ThatOneGuyDavid/retro-tv-frame/SHARE-POST.md

# A retro TV frame for a modern display — work in progress

I wanted the warmth and chunky controls of an old television around a modern flat screen, so I designed a printed-and-wooden frame with an olive-green sculpted surround, brass-finished knobs, and a perforated speaker grille.

I’m sharing this before final assembly so others can explore or adapt it. The current bezel is v8, with a flat inner printing land; its test print was successful on 2026-11-10. Display fit and final assembly checks are still underway. The illustrations are CAD views, not completed-build photographs.

The design combines a few useful fabrication ideas: a two-piece bezel with hidden joining keys, glue feet that set the glass clearance, tapered tabs that locate against the factory frame, separately paintable knob parts, and a thin faceplate captured in a grooved mitered wood frame.

The repository includes the current printable parts, editable source, a browser assembly viewer, woodworking dimensions and cut list, and a faceplate-only template for ordinary Letter paper. It also explains the fitting features and how to adapt the design to a different display, including measurement worksheets and CAD-assistant prompt suggestions.

It is specified by measurements rather than a named monitor. The files describe the decorative front and frame; speaker mounting, control electronics and the final structural support can be chosen for your build.

Everything is shared under MIT. I'd love to see other finishes and adaptations.
