ThatOneGuyDavid/retro-tv-frame/docs/dimensions.md

# Example dimensions and coordinate system

These dimensions describe the current **bezel v8** and matching assembly. The v8 test print was successful; installation fit remains to be checked.

All dimensions are millimeters unless labeled otherwise. These measurements describe a **generic square-edged reference envelope**, not a named display model. The glass and housing are modeled as one solid unit; no internal display construction is inferred.

## Display

| Measurement | Value |
| --- | ---: |
| Viewing width × height | 596.9 × 336.55 (23.5 × 13.25 inches) |
| Factory border top / bottom | 34 / 48 |
| Factory border left / right | 33 / 33 |
| Factory front above glass | 7 |
| Complete housing width × height × depth | 662.9 × 418.55 × 44 |

Origin is the **center of the viewing surface**, with glass front **Z=0**, X right, Y up, Z toward the viewer. Factory frame front is Z=7 and housing back Z=-37. Because the lower border is taller, the housing's outer center is Y=-7. Housing bounds are X=±331.45, Y=-216.275..202.275, Z=-37..7.

## Front parts

| Feature | Size / position |
| --- | --- |
| Green opening | 587 × 326 bounding size, exponent-4 superellipse |
| Green sculpted outside | 641 × 370, exponent-8 superellipse |
| Green complete flange | 681 × 384 |
| Printed half | 340.5 × 384 × 29, independently translated to print Z0 |
| Green inner underside / visible top | Z1 / Z3.4 |
| Flat inner printing land | 2.2 mm top/bottom; 2.7 mm sides; installed Z1 / print Z0 |
| Peak / flange front | Z30 |
| Flange rear | Z27 |
| Nominal shell thickness in Z | 2.4 |
| Glue-foot contact bottoms | Z7.2 |
| Key seating / pocket floor | Z10.1..11.1 / Z11.2 |
| Wood rear / front | Z30.2 / Z33.375 |
| Knob plate rear | Z33.575 |
| Fixed dial rear | Z36.775 |
| Knob forward extent | Z64.575 |
| Control centerline | X392.5 |
| Knob centers | Y130, Y40 |
| Knob mounting plate | 108 × 186 × 3, center X392.5/Y90 |
| Dial diameter / grip diameter | 76 / nominal 46 |
| Grille print | 100 × 192 × 3, center X392.5/Y-102, front Z30 |
| Visible grille opening | 100 × 160, R8 |
| Green-to-grille envelope gap | 2 |

The rounded green opening overlaps the straight glass rectangle by approximately 5 mm per axis at the straight middle edges and more at the corners. It is an intentional mask; this is not a design for preserving every pixel of a rectangular image.

## Wood

| Feature | Value |
| --- | --- |
| Panel width × height | 803.2 × 434.75 |
| Panel thickness | 3.175 |
| Panel X bounds | -348.6..454.6 |
| Panel Y bounds | -224.375..210.375 |
| Rail inside X bounds | -342.5..448.5 |
| Rail inside Y bounds | -218.275..204.275 |
| Frame outside width × height | 829.1 × 460.65 |
| Rail cross-section | 19.05 front width × 76.2 rearward depth |
| Frame front / rear | Z36.375 / Z-39.825 |
| Groove depth / width | 6.35 / 3.575 |
| Groove front/back from rail front | 2.8 / 6.375 |
| Panel front setback from rail front | 3 |
| Screen wood opening | 640 × 369 curved contour |
| Speaker wood opening | 100 × 160, R8 |

Faceplate drawing is front view, TOP up. Match the actual curved screen contour; dimensions alone do not reproduce its corners. Shaft holes are not in the clean woodworking template because the hardware-specific openings have not been selected.
