ThatOneGuyDavid/retro-tv-frame/design/faceplate/faceplate-letter-tiled.pdf

0 | 50 | 100

100 mm check

1 inch square

WOOD FACEPLATE — US LETTER TEMPLATE

Print every page at ACTUAL SIZE / 100%. Disable Fit, Shrink, and Scale to printable area. Use 8.5 × 11 inch portrait paper, one-sided.

First verify the 100 mm bar below with a ruler.
The 1 inch square must measure 25.4 mm on both axes. If either dimension is wrong, do not use the template.

Tiles: 5 columns × 2 rows; 10 mm overlap.
Arrange row 1 above row 2; columns left to right. Trim ONE side of each shared margin, overlap the drawings, and match grid crosses and cut lines.
Do not align by paper edges alone.

SOLID black lines: outer wood boundary and cutouts. Fine crosses and dotted lines are tile alignment guides. Only the faceplate boundary and cutouts are shown.

Panel: 803.2 × 434.75 mm; screen opening: 640 × 369 mm. Screen contour is curved, NOT a bounding rectangle. Grille opening: 100 × 160 mm, corner radius 8 mm.
View is FRONT / TOP UP. Attach template to wood front.

Dry-fit printed parts before cutting final material.

1/8 inch wood shown in assembly; thinner is possible. Check against the actual prints before cutting wood.

TOP / FRONT VIEW

R1 C1 | FRONT / TOP UP | Actual size 100% | 10 mm overlap

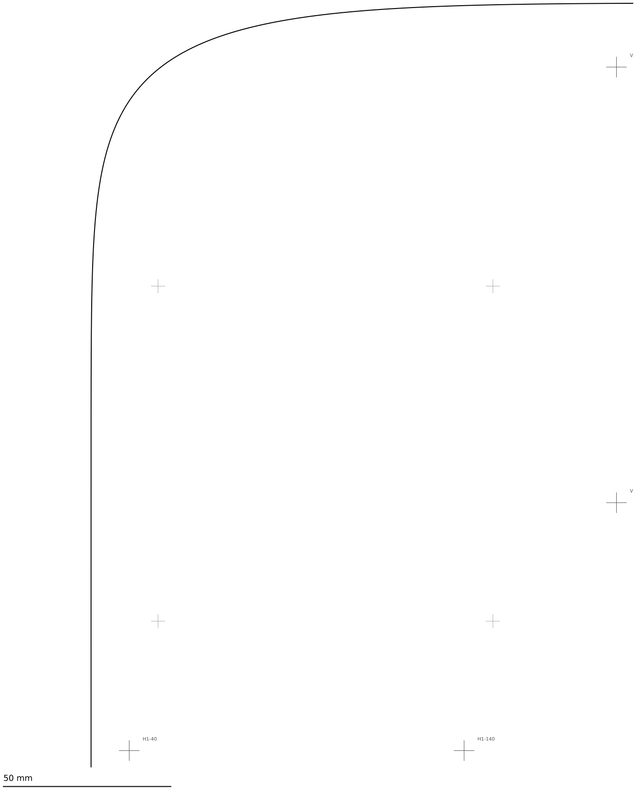
[picture p3: figure]

SCREEN CUTOUT

V1-1-45

V1-1-175

V2-1-45

V2-1-175

R1 C2 | FRONT / TOP UP | Actual size 100% | 10 mm overlap

SCREEN CUTOUT

V2-1-45

V2-1-175

V3-1-45

V3-1-175

R1 C3 | FRONT / TOP UP | Actual size 100% | 10 mm overlap

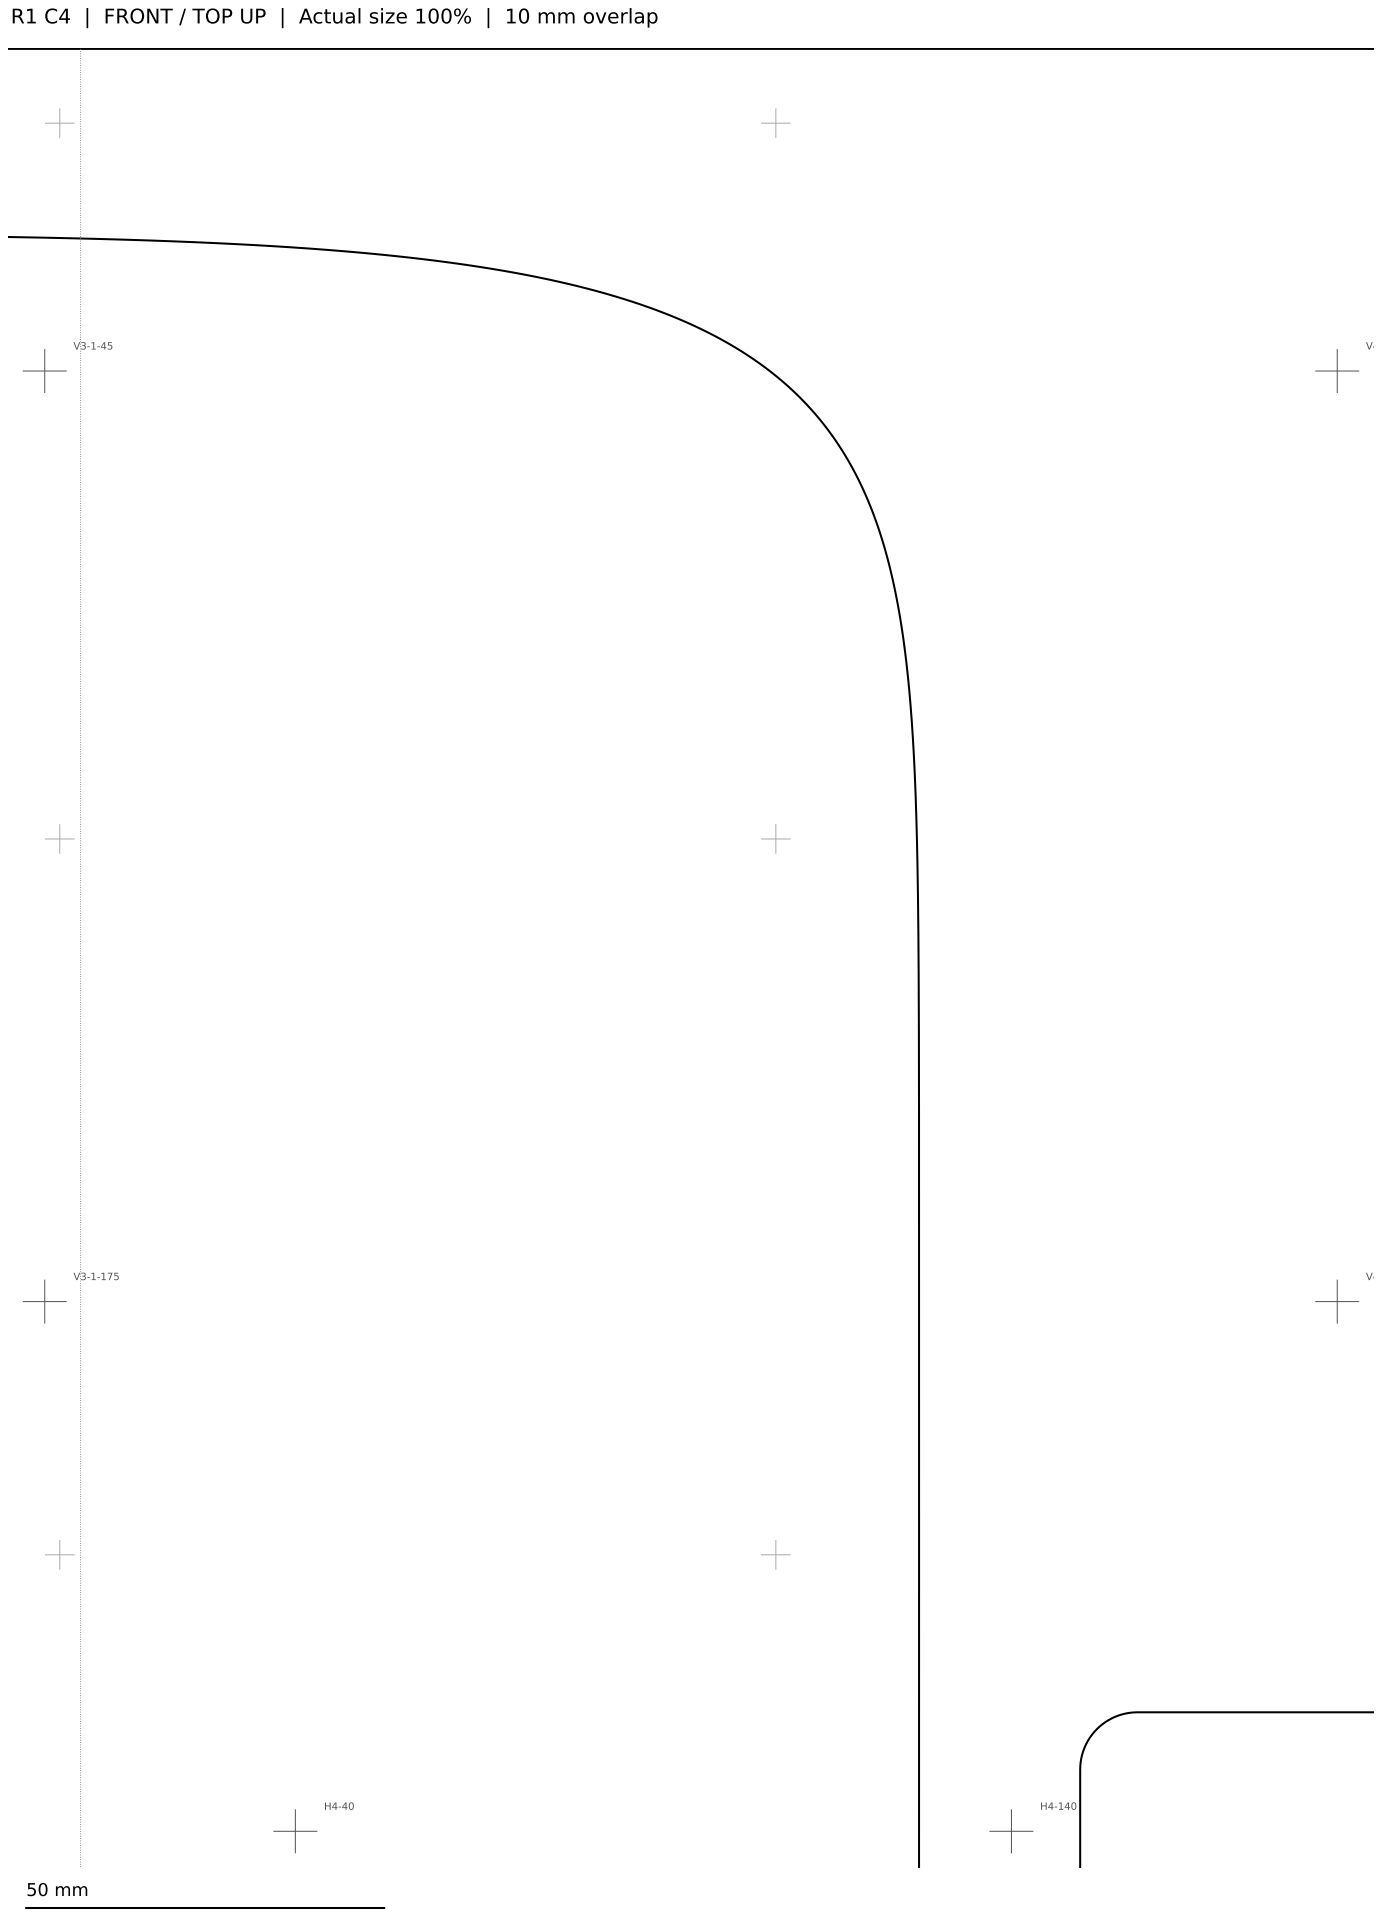
[picture p4: page 5]

R1 C4 | FRONT / TOP UP | Actual size 100% | 10 mm overlap

V4-1-45

V4-1-175

R1 C5 | FRONT / TOP UP | Actual size 100% | 10 mm overlap

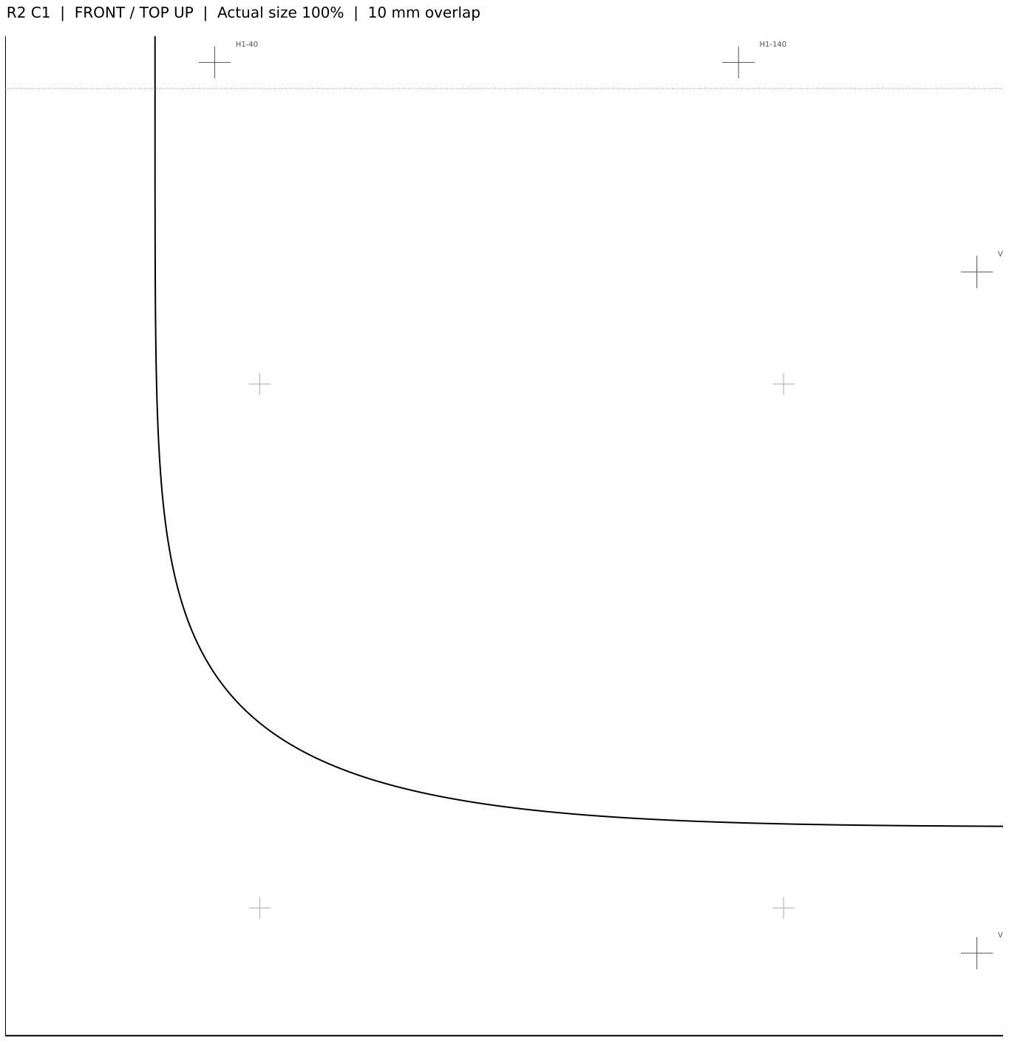
[picture p5: figure]

R2 C1 | FRONT / TOP UP | Actual size 100% | 10 mm overlap

V1-2-45

V1-2-175

V2-2-45

V2-2-175

R2 C2 | FRONT / TOP UP | Actual size 100% | 10 mm overlap

V2-2-45

V2-2-175

V3-2-45

V3-2-175

R2 C3 | FRONT / TOP UP | Actual size 100% | 10 mm overlap

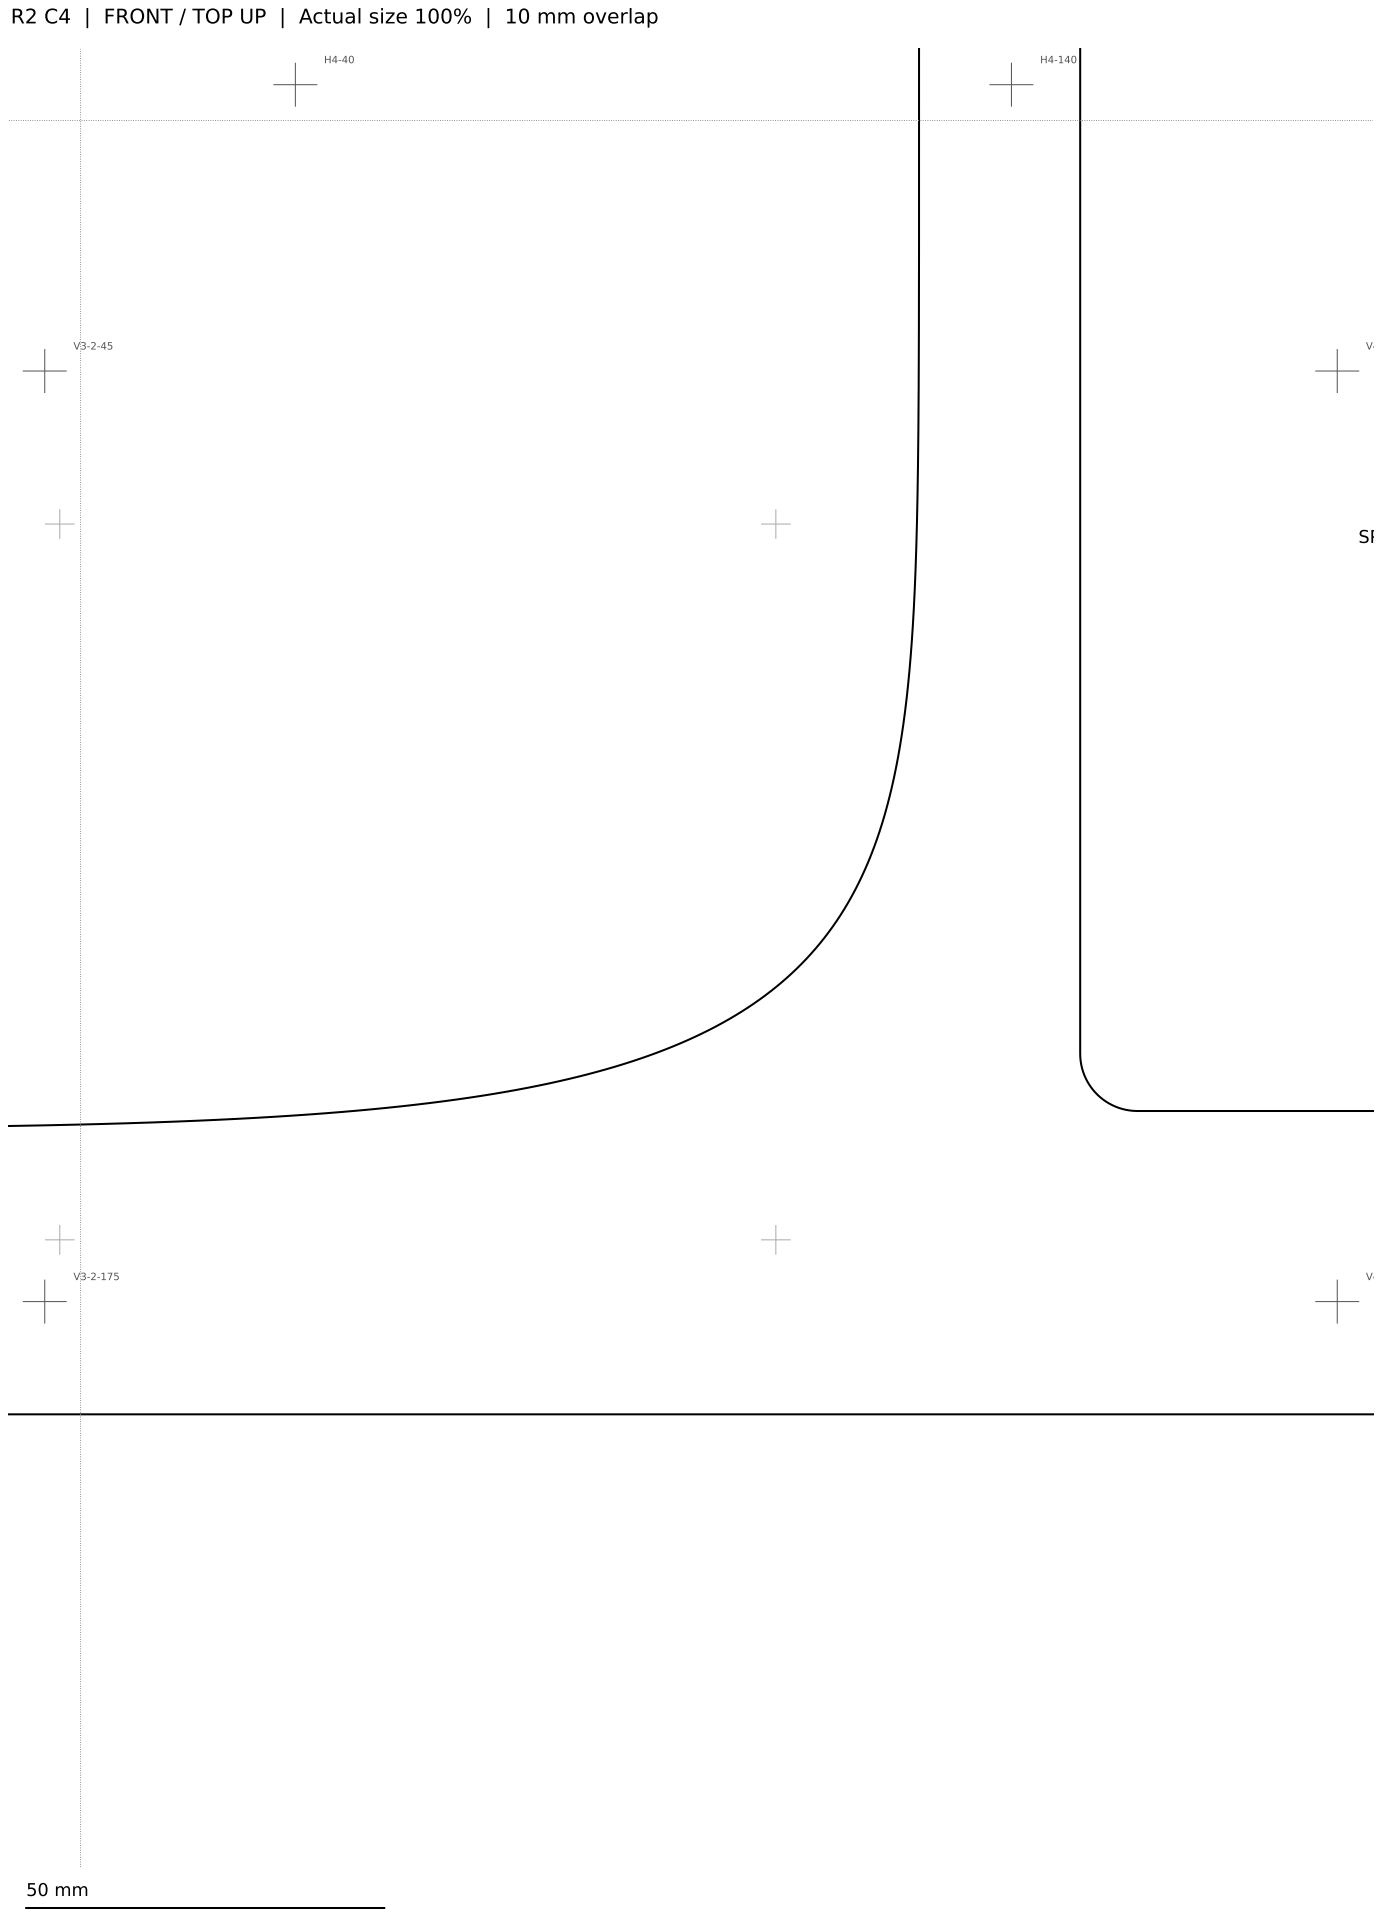
[picture p6: page 10]
SPEAKER CUTOUT

R2 C4 | FRONT / TOP UP | Actual size 100% | 10 mm overlap

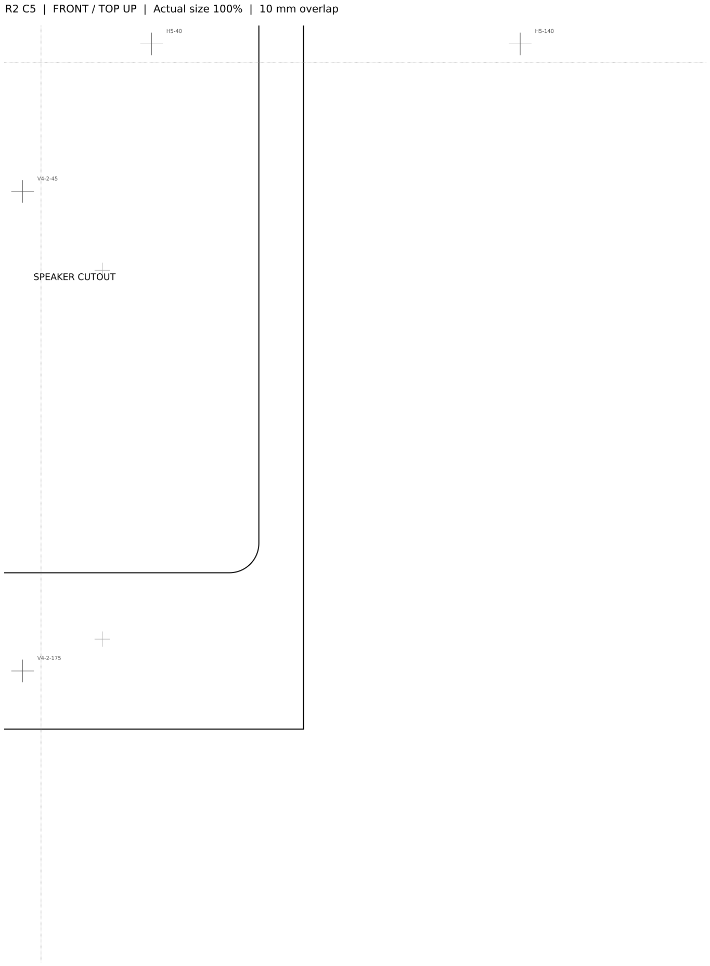
[picture p7: figure]
SPEAKER CUTOUT

R2 C5 | FRONT / TOP UP | Actual size 100% | 10 mm overlap
