ThatOneGuyDavid/retro-tv-frame/design/bezel/first-layer-brim.png

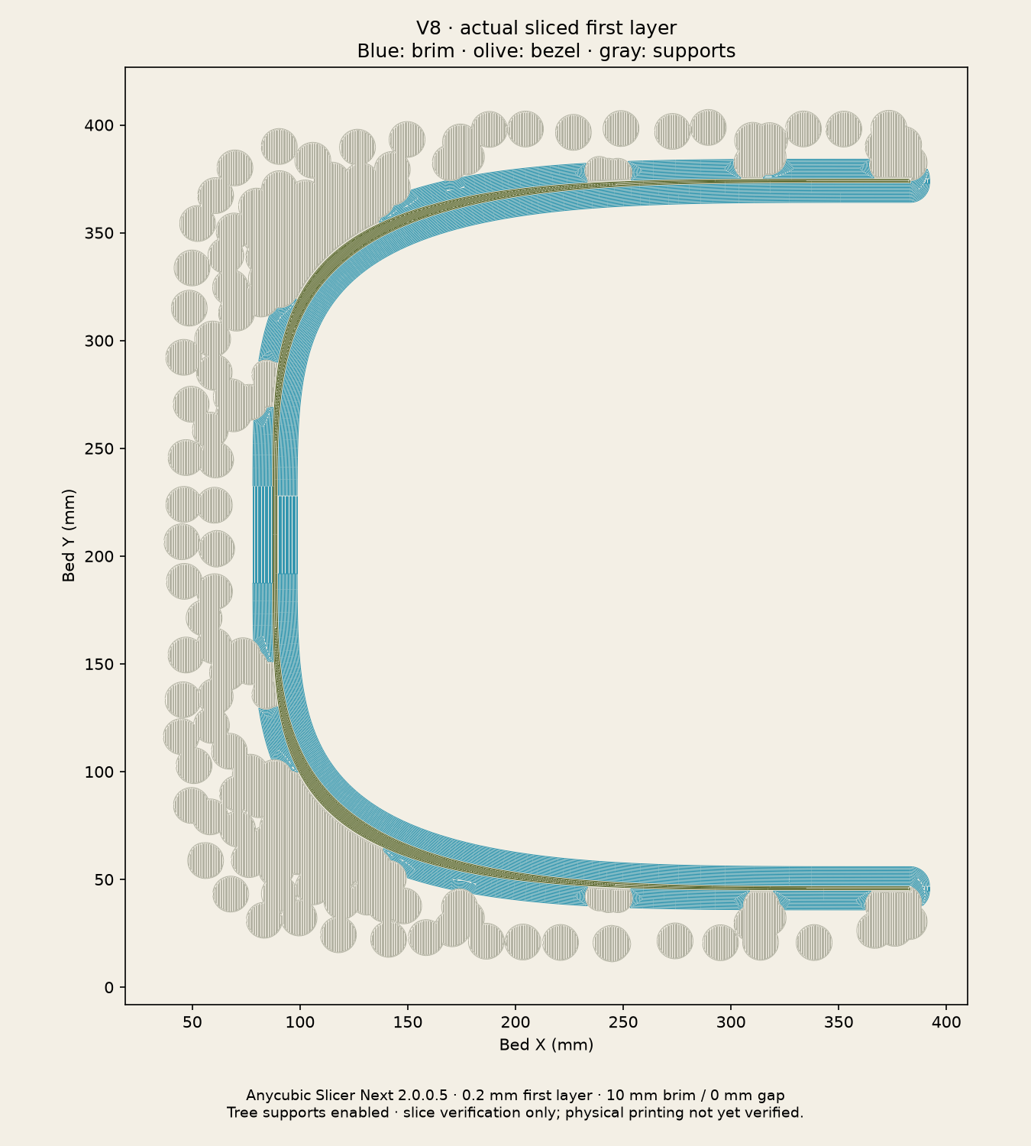
design/bezel/first-layer-brim.png
