ThatOneGuyDavid/retro-tv-frame/design/faceplate/faceplate-preview.png

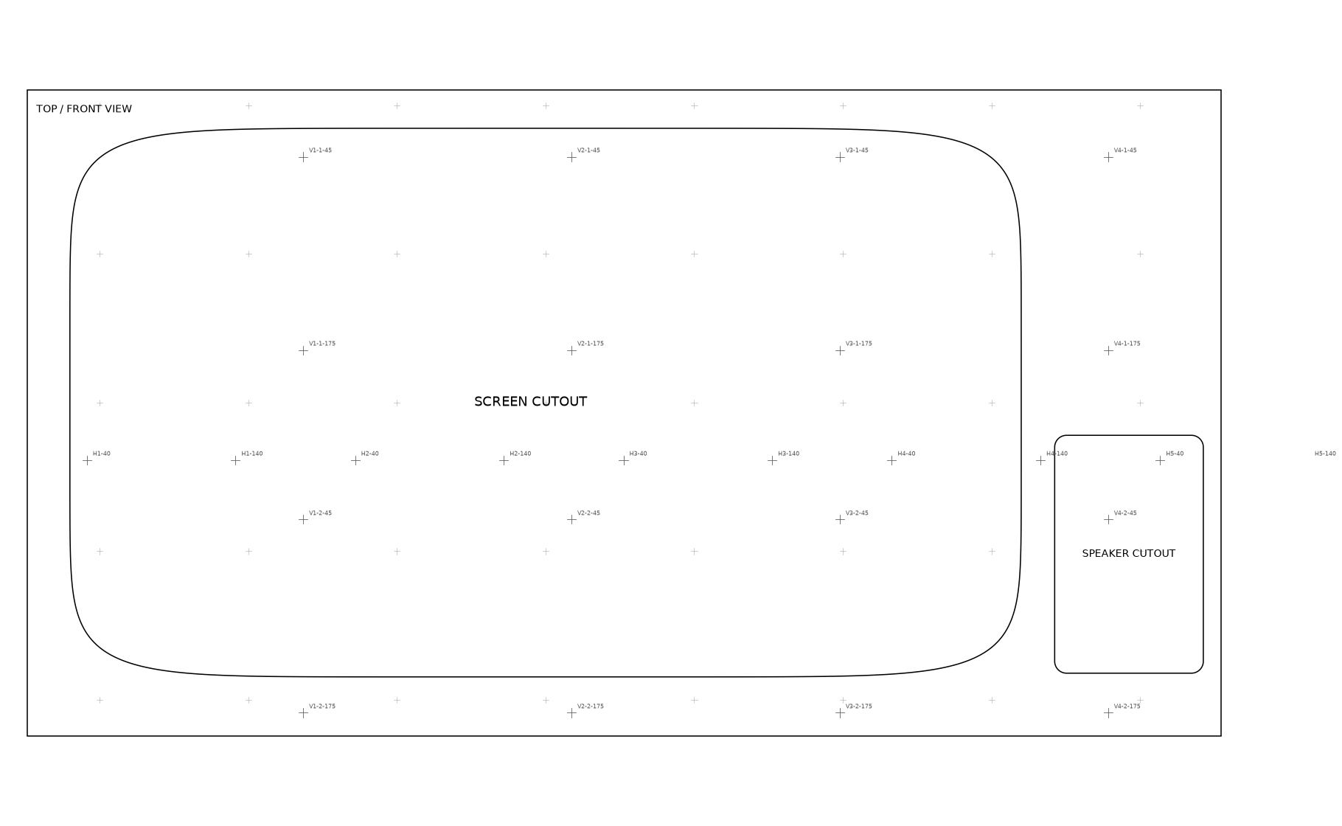
design/faceplate/faceplate-preview.png
