ThatOneGuyDavid/retro-tv-frame/design/grille/grille-preview.png

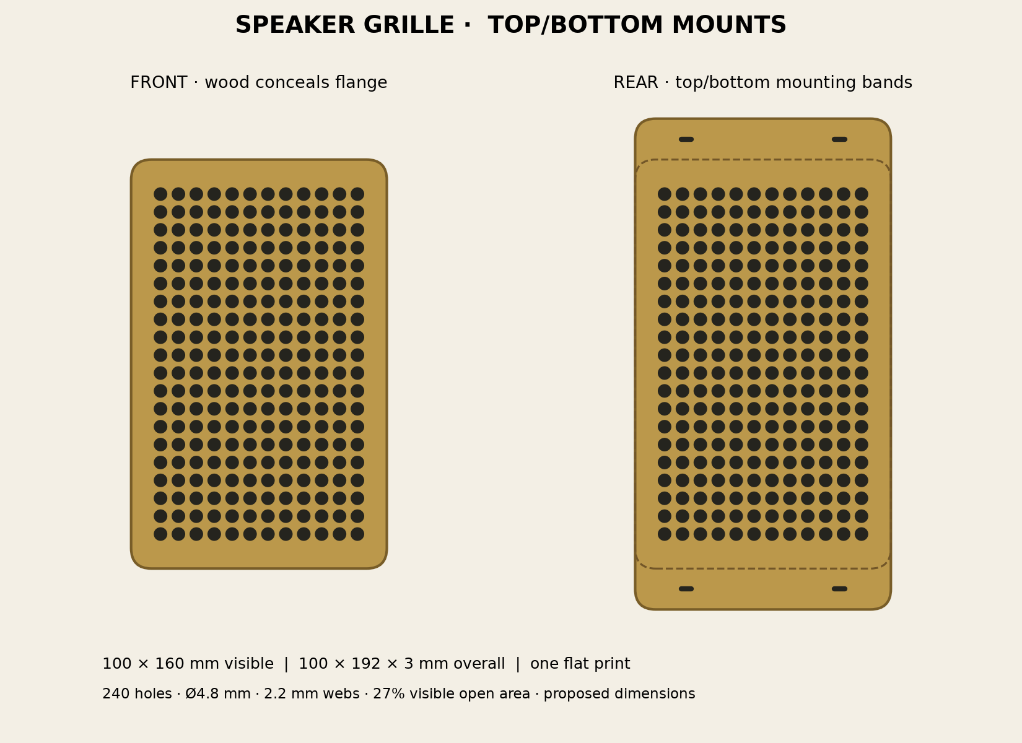
design/grille/grille-preview.png
