ThatOneGuyDavid/retro-tv-frame/design/knobs/knob-exploded.png

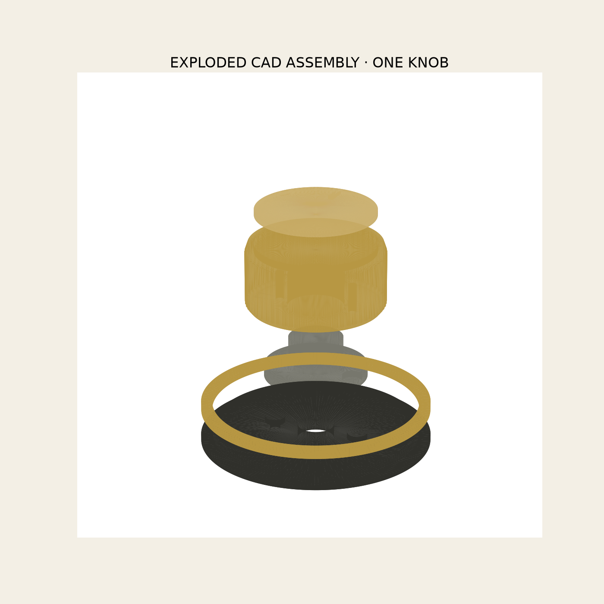
design/knobs/knob-exploded.png
