ThatOneGuyDavid/retro-tv-frame/design/knobs/knob-preview.png

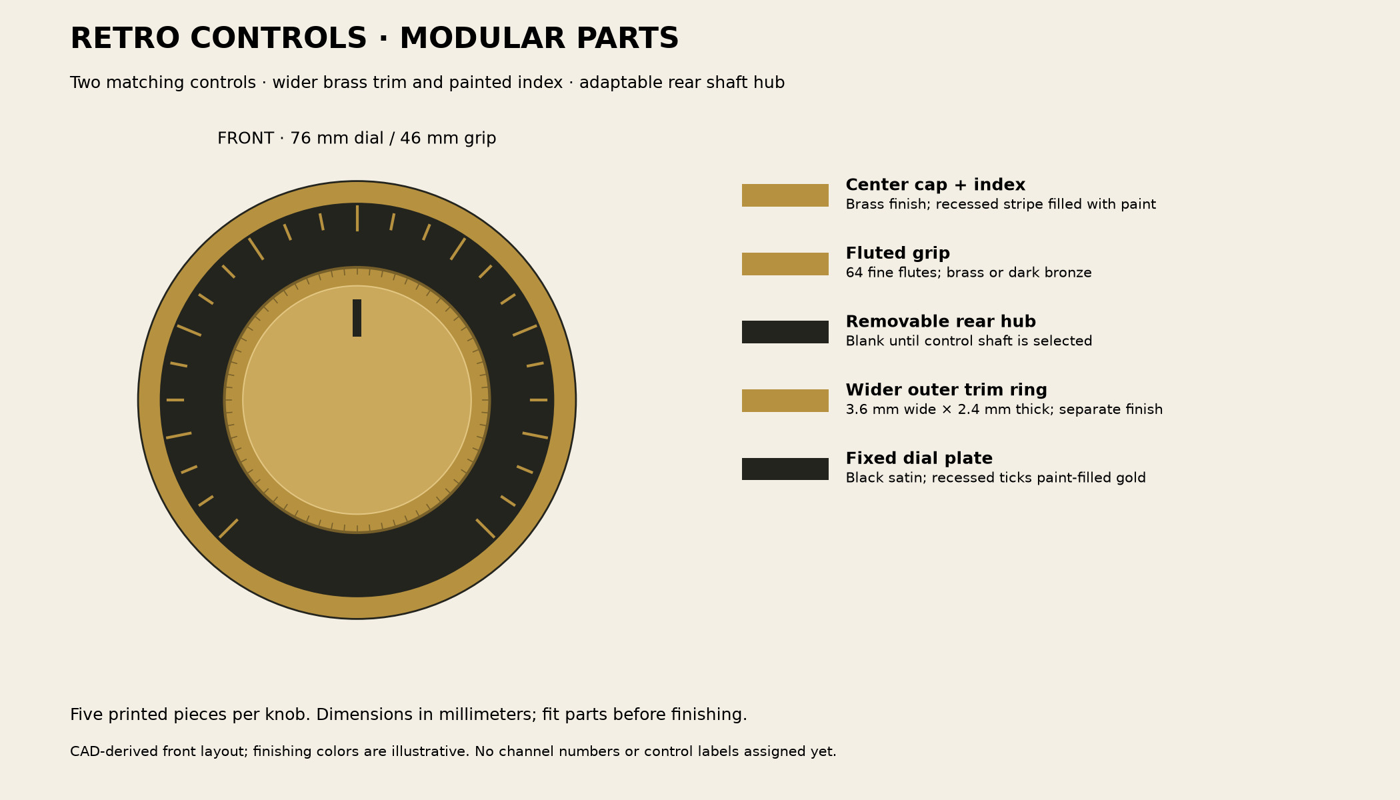
design/knobs/knob-preview.png
