ThatOneGuyDavid/retro-tv-frame/design/bezel/bezel-assembled.step

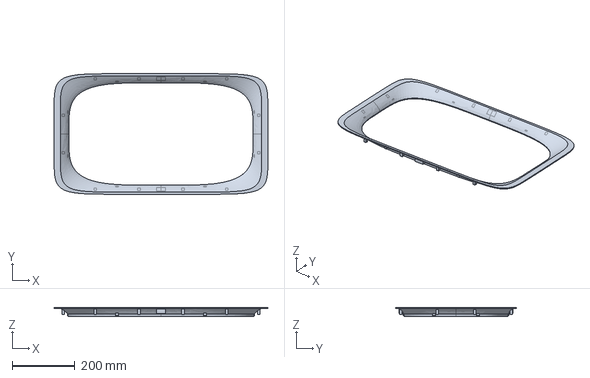
[picture p13: CAD file, 2026-11-12]
design/bezel/bezel-assembled.step
681.0 x 384.0 x 29.0 mm
