ThatOneGuyDavid/retro-tv-frame/design/assembly/wood-frame-bottom-reference.stl

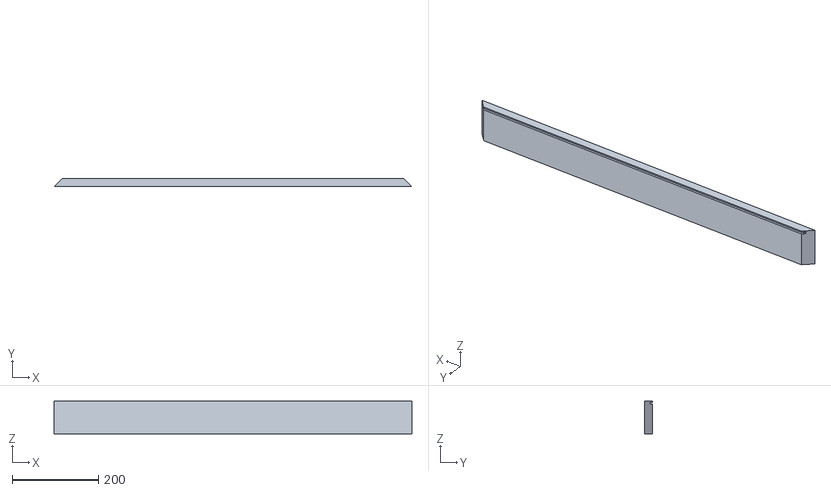
[picture p14: CAD file, 2026-11-09]
design/assembly/wood-frame-bottom-reference.stl
829.1 x 19.1 x 76.2
