ThatOneGuyDavid/retro-tv-frame/design/bezel/bezel-right.step

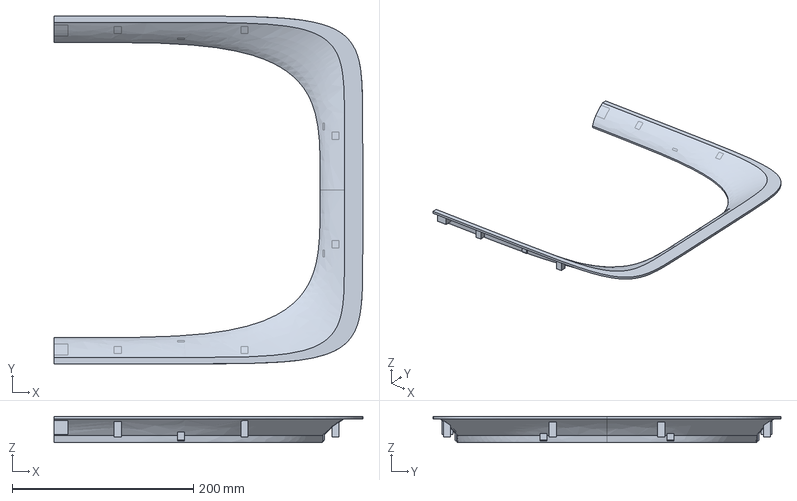
[picture p15: CAD file, 2026-11-12]
design/bezel/bezel-right.step
340.5 x 384.0 x 29.0 mm
