ThatOneGuyDavid/retro-tv-frame/design/display/display-reference.stl

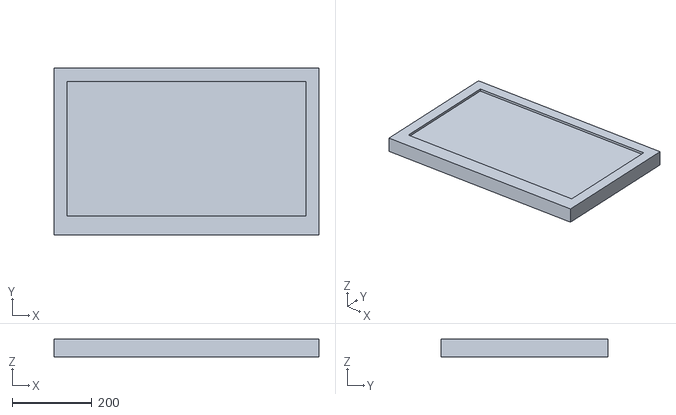
[picture p16: CAD file, 2026-11-09]
design/display/display-reference.stl
662.9 x 418.5 x 44.0
