ThatOneGuyDavid/retro-tv-frame/design/grille/speaker-grille.stl

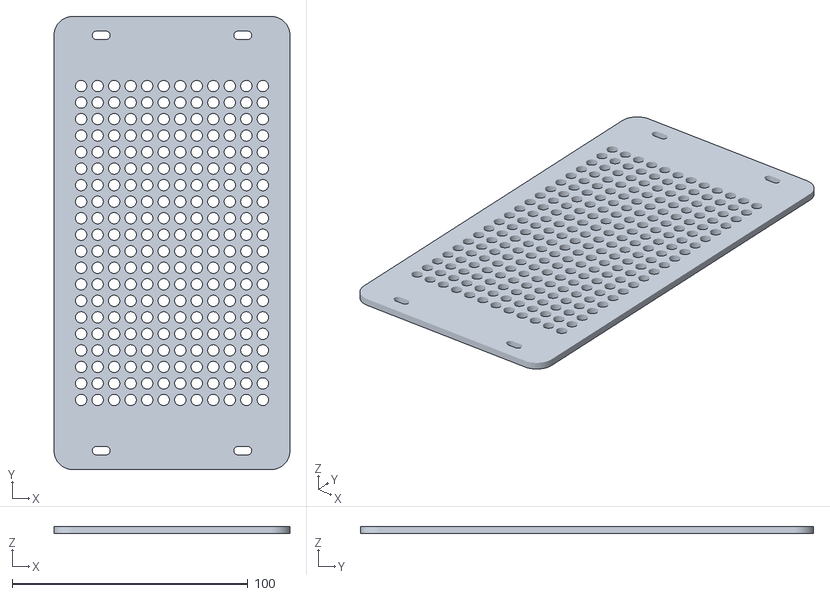
[picture p17: CAD file, 2026-11-09]
design/grille/speaker-grille.stl
100.0 x 192.0 x 3.00
