ThatOneGuyDavid/retro-tv-frame/design/knobs/fluted-grip.stl

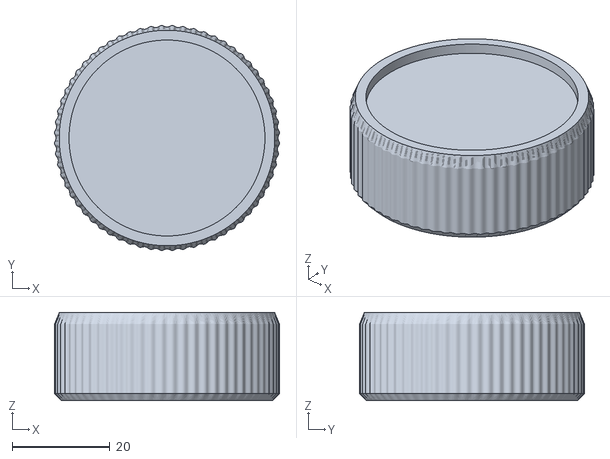
[picture p18: CAD file, 2026-11-09]
design/knobs/fluted-grip.stl
45.9 x 45.9 x 18.0
