ThatOneGuyDavid/retro-tv-frame/design/assembly/knob-mounting-plate.stl

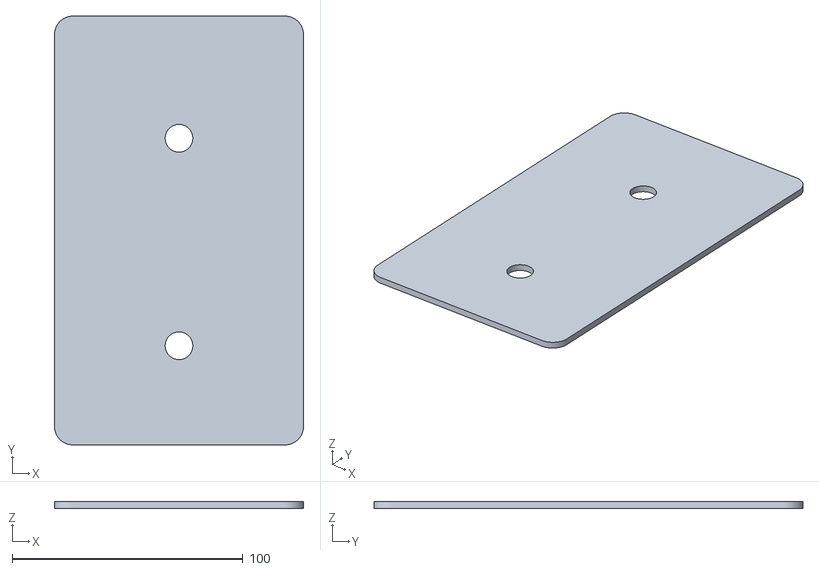
[picture p19: CAD file, 2026-11-09]
design/assembly/knob-mounting-plate.stl
108.0 x 186.0 x 3.00
