ThatOneGuyDavid/retro-tv-frame/design/bezel/joining-key.step

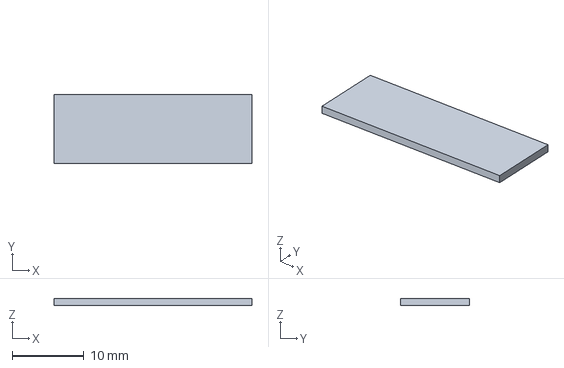
[picture p20: CAD file, 2026-11-12]
design/bezel/joining-key.step
27.6 x 9.60 x 1.00 mm
