ThatOneGuyDavid/retro-tv-frame/design/grille/perforation-test.stl

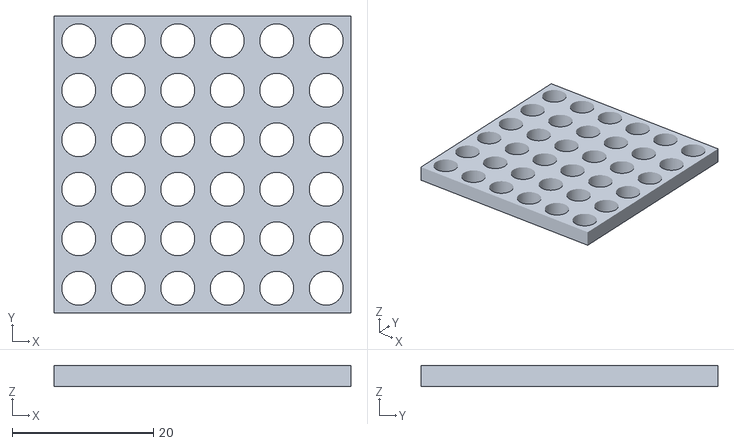
[picture p21: CAD file, 2026-11-09]
design/grille/perforation-test.stl
42.0 x 42.0 x 3.00
