ThatOneGuyDavid/retro-tv-frame/design/knobs/dial-plate.stl

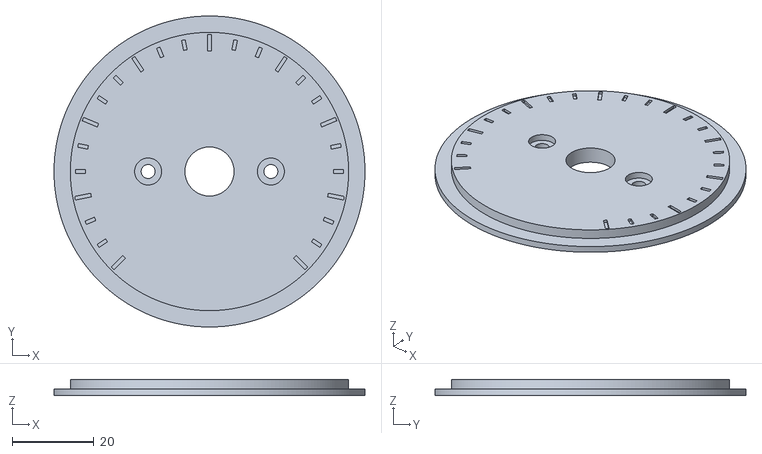
[picture p22: CAD file, 2026-11-09]
design/knobs/dial-plate.stl
76.0 x 76.0 x 4.00
