ThatOneGuyDavid/retro-tv-frame/design/assembly/wood-frame-left-reference.stl

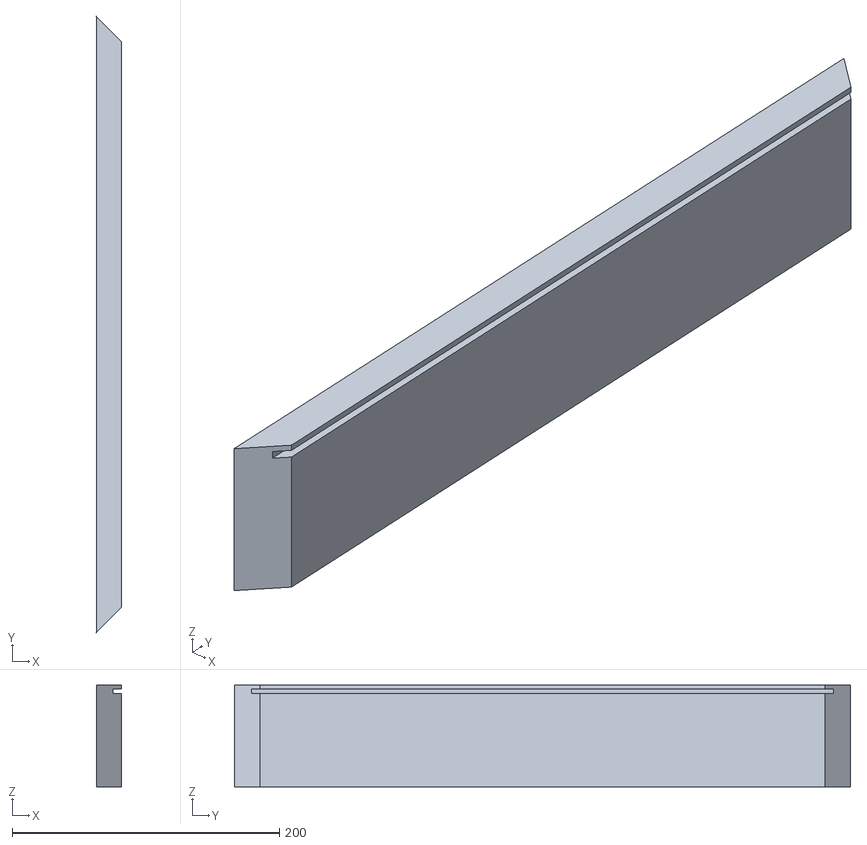
[picture p23: CAD file, 2026-11-09]
design/assembly/wood-frame-left-reference.stl
19.0 x 460.6 x 76.2
