ThatOneGuyDavid/retro-tv-frame/design/knobs/brass-trim.stl

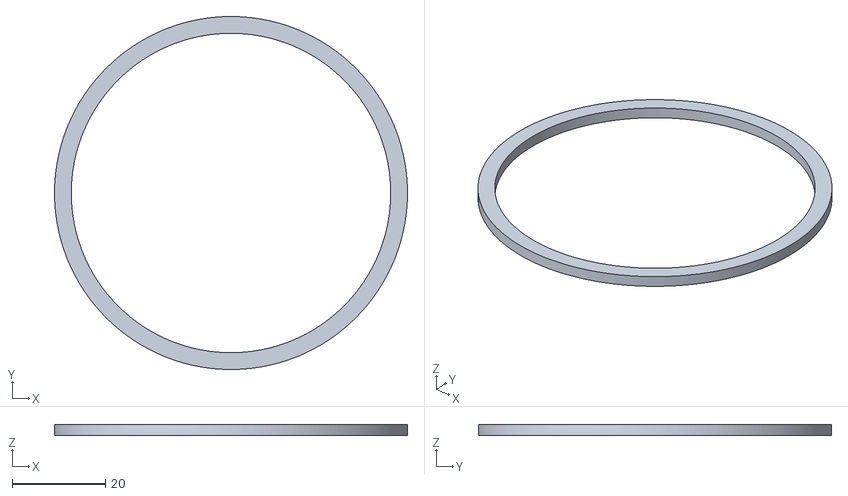
[picture p24: CAD file, 2026-11-09]
design/knobs/brass-trim.stl
75.6 x 75.6 x 2.40
