ThatOneGuyDavid/retro-tv-frame/design/knobs/blank-hub.stl

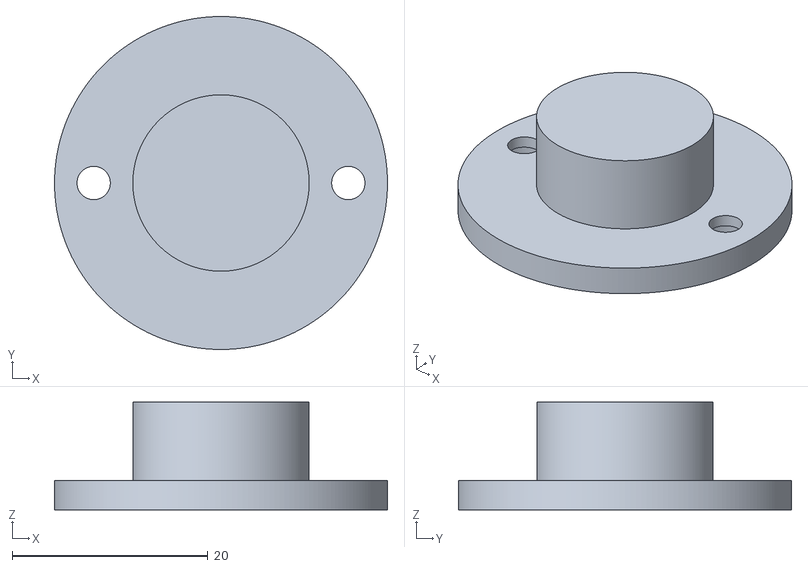
[picture p25: CAD file, 2026-11-09]
design/knobs/blank-hub.stl
34.0 x 34.0 x 11.0
