ThatOneGuyDavid/retro-tv-frame/design/assembly/wood-faceplate-reference.stl

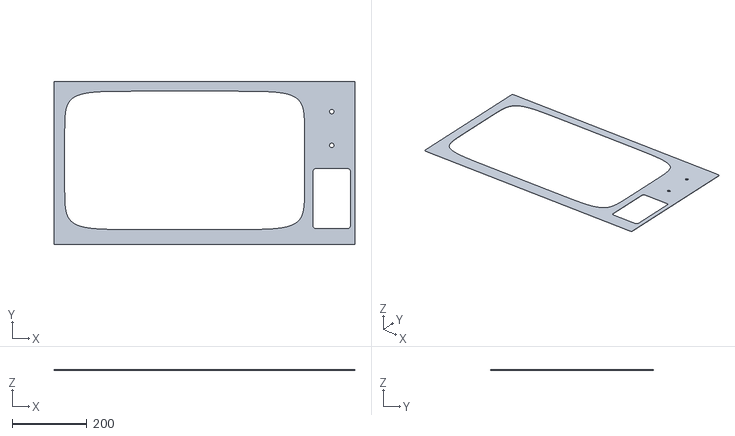
[picture p26: CAD file, 2026-11-09]
design/assembly/wood-faceplate-reference.stl
803.2 x 434.8 x 3.17
