ThatOneGuyDavid/retro-tv-frame/design/bezel/joint-test-left.stl

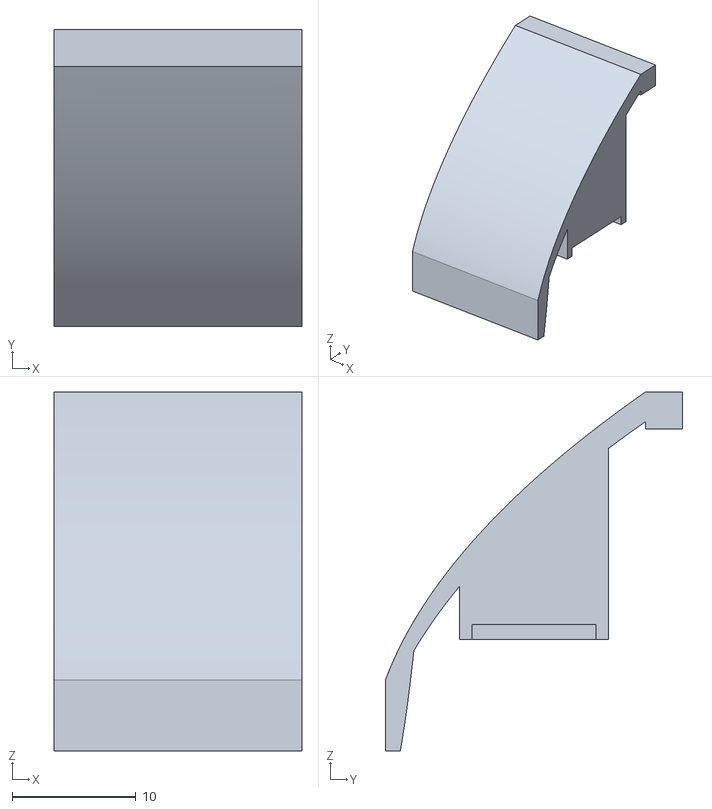
[picture p27: CAD file, 2026-11-09]
design/bezel/joint-test-left.stl
20.0 x 24.0 x 29.0
