ThatOneGuyDavid/retro-tv-frame/design/knobs/center-cap.stl

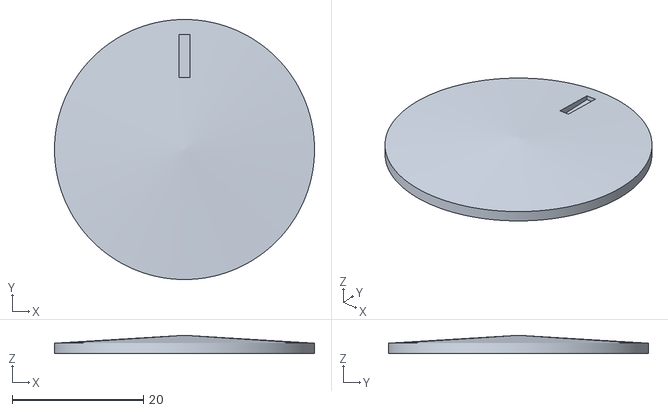
[picture p28: CAD file, 2026-11-09]
design/knobs/center-cap.stl
39.6 x 39.6 x 2.80
