ThatOneGuyDavid/retro-tv-frame/design/bezel/alignment-fit-test.stl

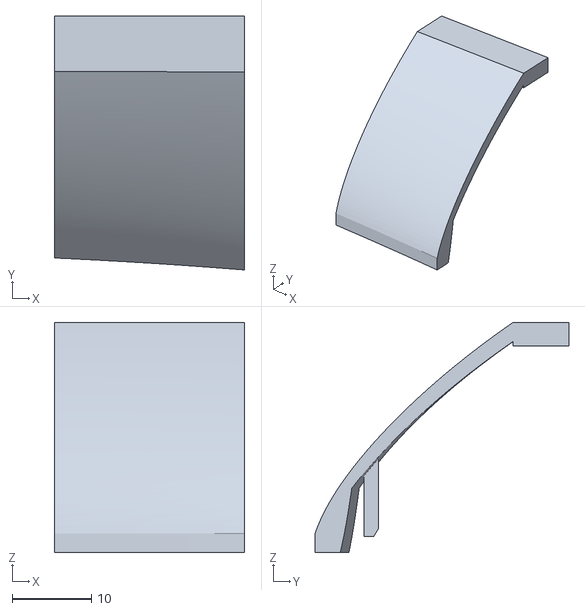
[picture p29: CAD file, 2026-11-09]
design/bezel/alignment-fit-test.stl
24.0 x 32.0 x 29.0
