ThatOneGuyDavid/retro-tv-frame/design/bezel/display-fit-test.stl

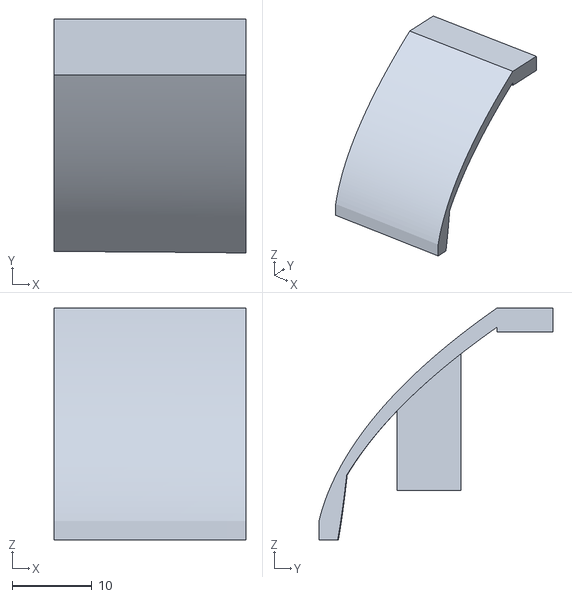
[picture p30: CAD file, 2026-11-09]
design/bezel/display-fit-test.stl
24.0 x 29.2 x 29.0
