ThatOneGuyDavid/retro-tv-frame/(list of files, cad)

Other CAD files:
design/assembly/wood-frame-right-reference.stl
design/bezel/bezel-left.step
design/assembly/wood-frame-top-reference.stl
design/bezel/joint-test-right.stl
design/bezel/bezel-assembled.stl
design/bezel/bezel-left.stl
design/bezel/bezel-right.stl
design/bezel/joining-key.stl
