ThatOneGuyDavid/retro-tv-frame/design/assembly/faceplate-letter-tiled.pdf

0 | 50 | 100

100 mm check

1 inch square

WOOD FACEPLATE — US LETTER TEMPLATE

Print every page at ACTUAL SIZE / 100%. Disable Fit, Shrink, and Scale to printable area. Use 8.5 × 11 inch portrait paper, one-sided.

First verify the 100 mm bar below with a ruler.
The 1 inch square must measure 25.4 mm on both axes. If either dimension is wrong, do not use the template.

Tiles: 5 columns × 2 rows; 10 mm overlap.
Arrange row 1 above row 2; columns left to right. Trim ONE side of each shared margin, overlap the drawings, and match grid crosses and cut lines.
Do not align by paper edges alone.

SOLID black lines: outer wood boundary and cutouts. DASHED lines: component placement — DO NOT CUT.

DASH-DOT rectangle: inside opening of frame. Dashed Ø12 access circles: leave undrilled until
the control hardware and shaft support are selected.
No fastener holes are needed for glued mounting.

Panel: 803.2 × 434.75 mm; screen opening: 640 × 369 mm. Screen contour is curved, NOT a bounding rectangle. Grille opening: 100 × 160 mm, corner radius 8 mm.
View is FRONT / TOP UP. Attach template to wood front.

Dry-fit printed parts before cutting final material.

1/8 inch wood shown in assembly; thinner is possible. Actual shaft hardware and glue performance untested.

TOP / FRONT VIEW — solid: cut; dashed: placement only

R1 C1 | FRONT / TOP UP | Actual size 100% | 10 mm overlap

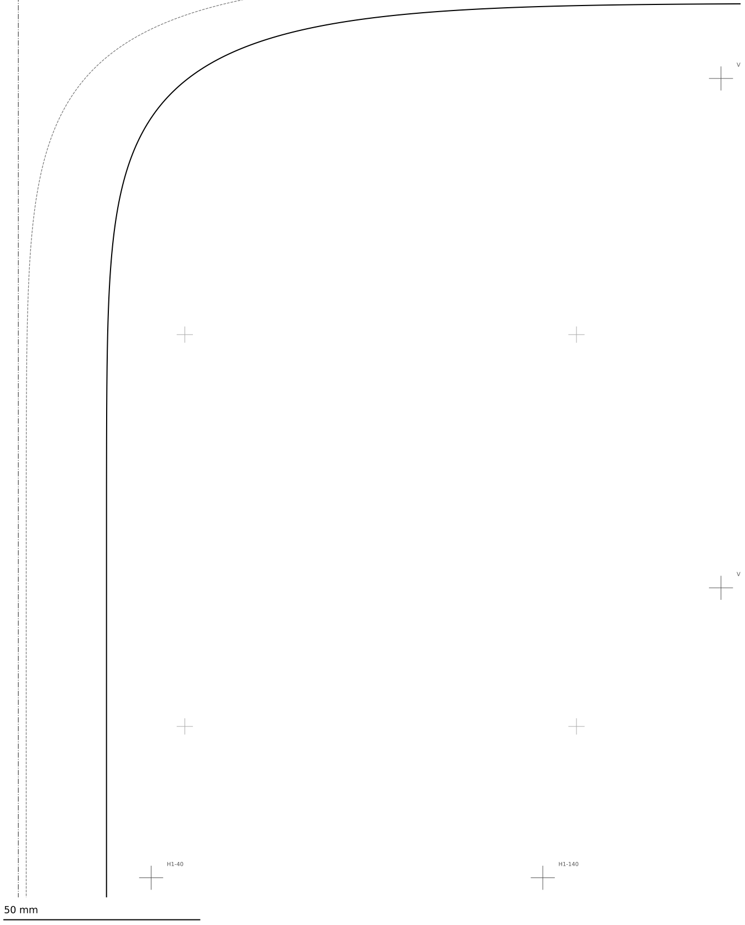
[picture p32: figure]

SCREEN CUTOUT
640 × 369 mm
0.5 mm nominal rim overlap

V1-1-45

V1-1-175

V2-1-45

V2-1-175

R1 C2 | FRONT / TOP UP | Actual size 100% | 10 mm overlap

SCREEN CUTOUT
640 × 369 mm
0.5 mm nominal rim overlap

V2-1-45

V2-1-175

V3-1-45

V3-1-175

R1 C3 | FRONT / TOP UP | Actual size 100% | 10 mm overlap

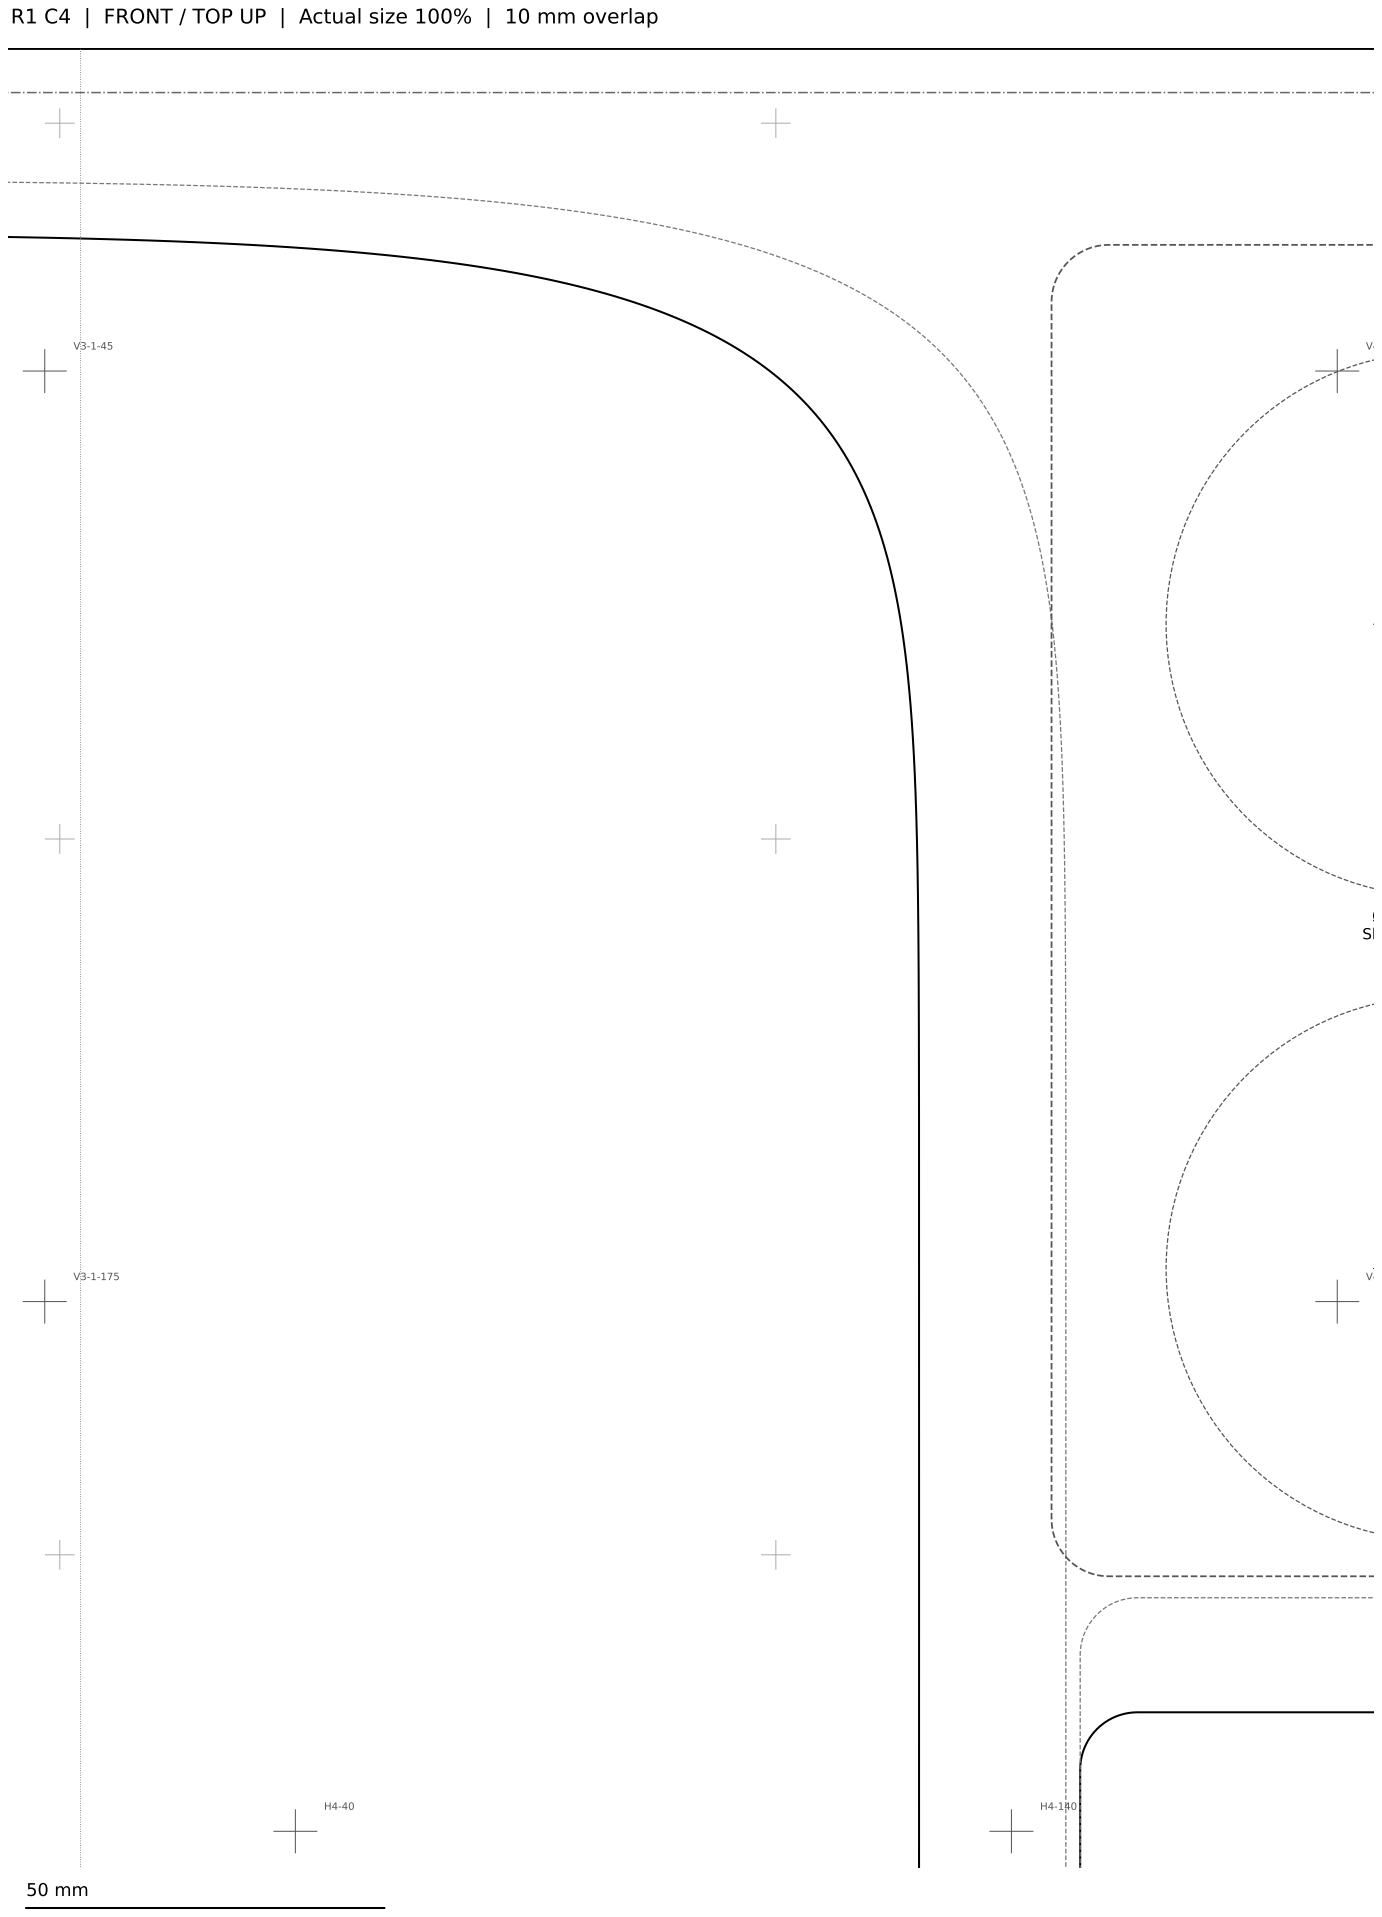
[picture p33: page 5]

R1 C4 | FRONT / TOP UP | Actual size 100% | 10 mm overlap

Ø12 access holes
Shaft hardware TBD

R1 C5 | FRONT / TOP UP | Actual size 100% | 10 mm overlap

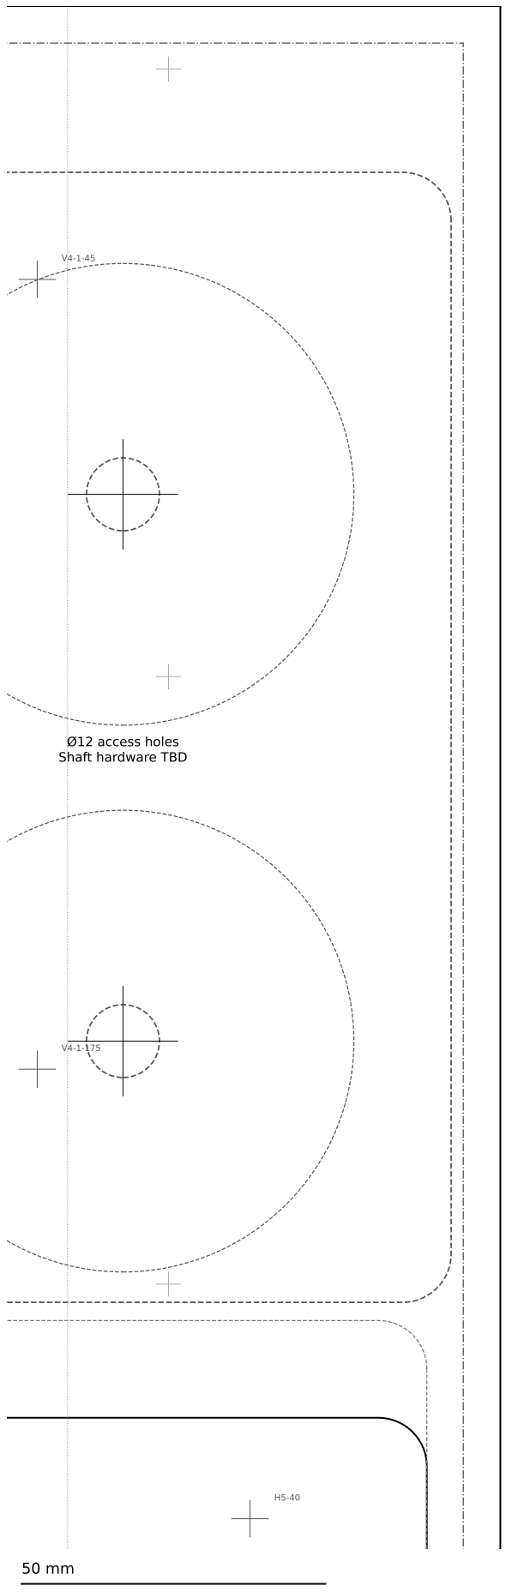
[picture p34: figure]
Ø12 access holes Shaft hardware TBD
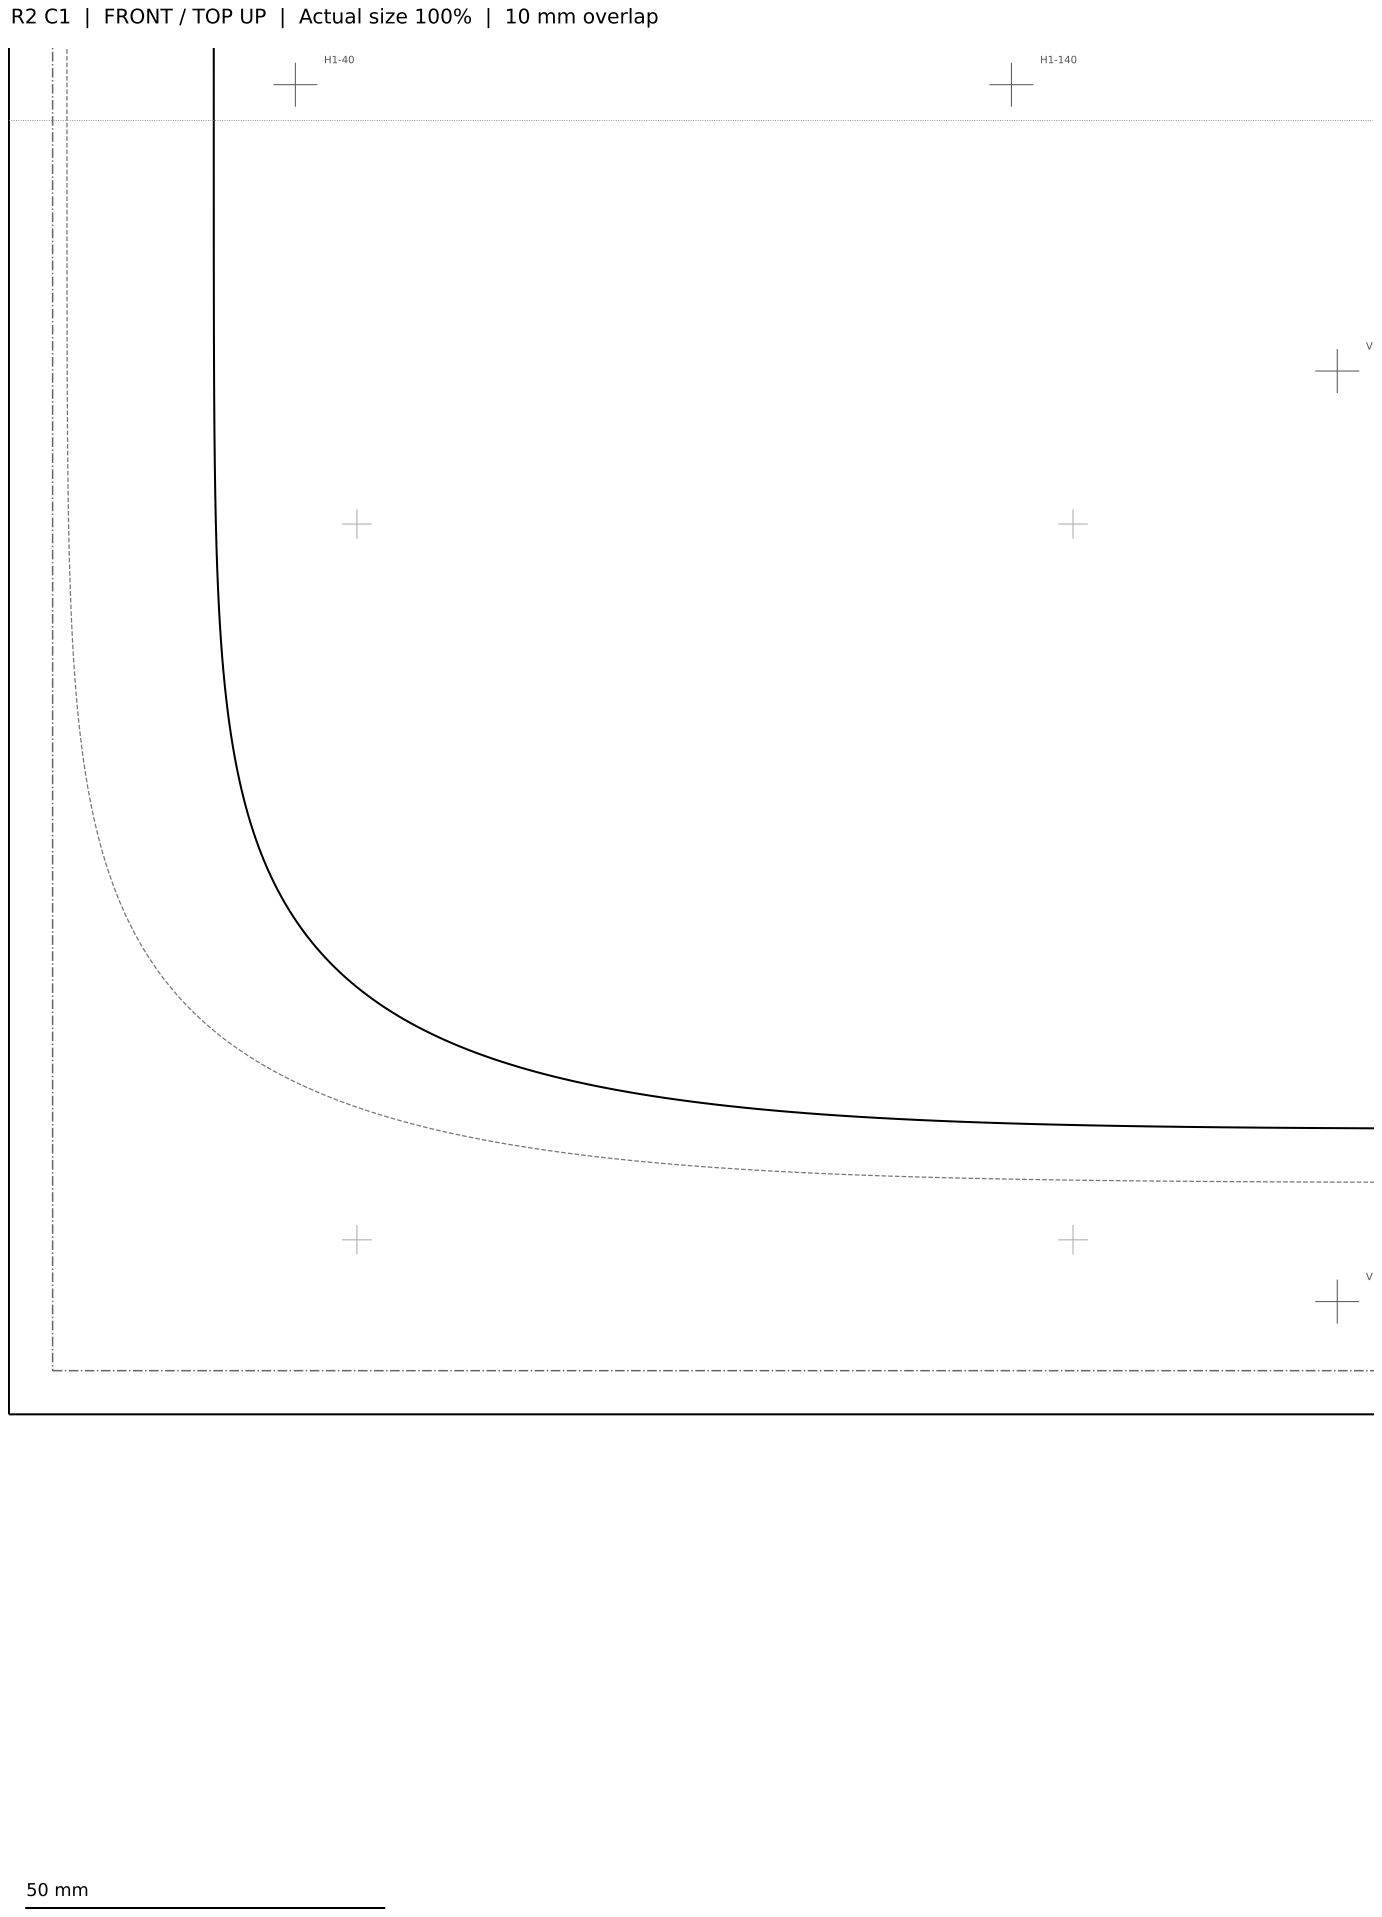
[picture p35: page 7]

R2 C1 | FRONT / TOP UP | Actual size 100% | 10 mm overlap

V1-2-45

V1-2-175

V2-2-45

V2-2-175

R2 C2 | FRONT / TOP UP | Actual size 100% | 10 mm overlap

V2-2-45

V2-2-175

V3-2-45

V3-2-175

R2 C3 | FRONT / TOP UP | Actual size 100% | 10 mm overlap

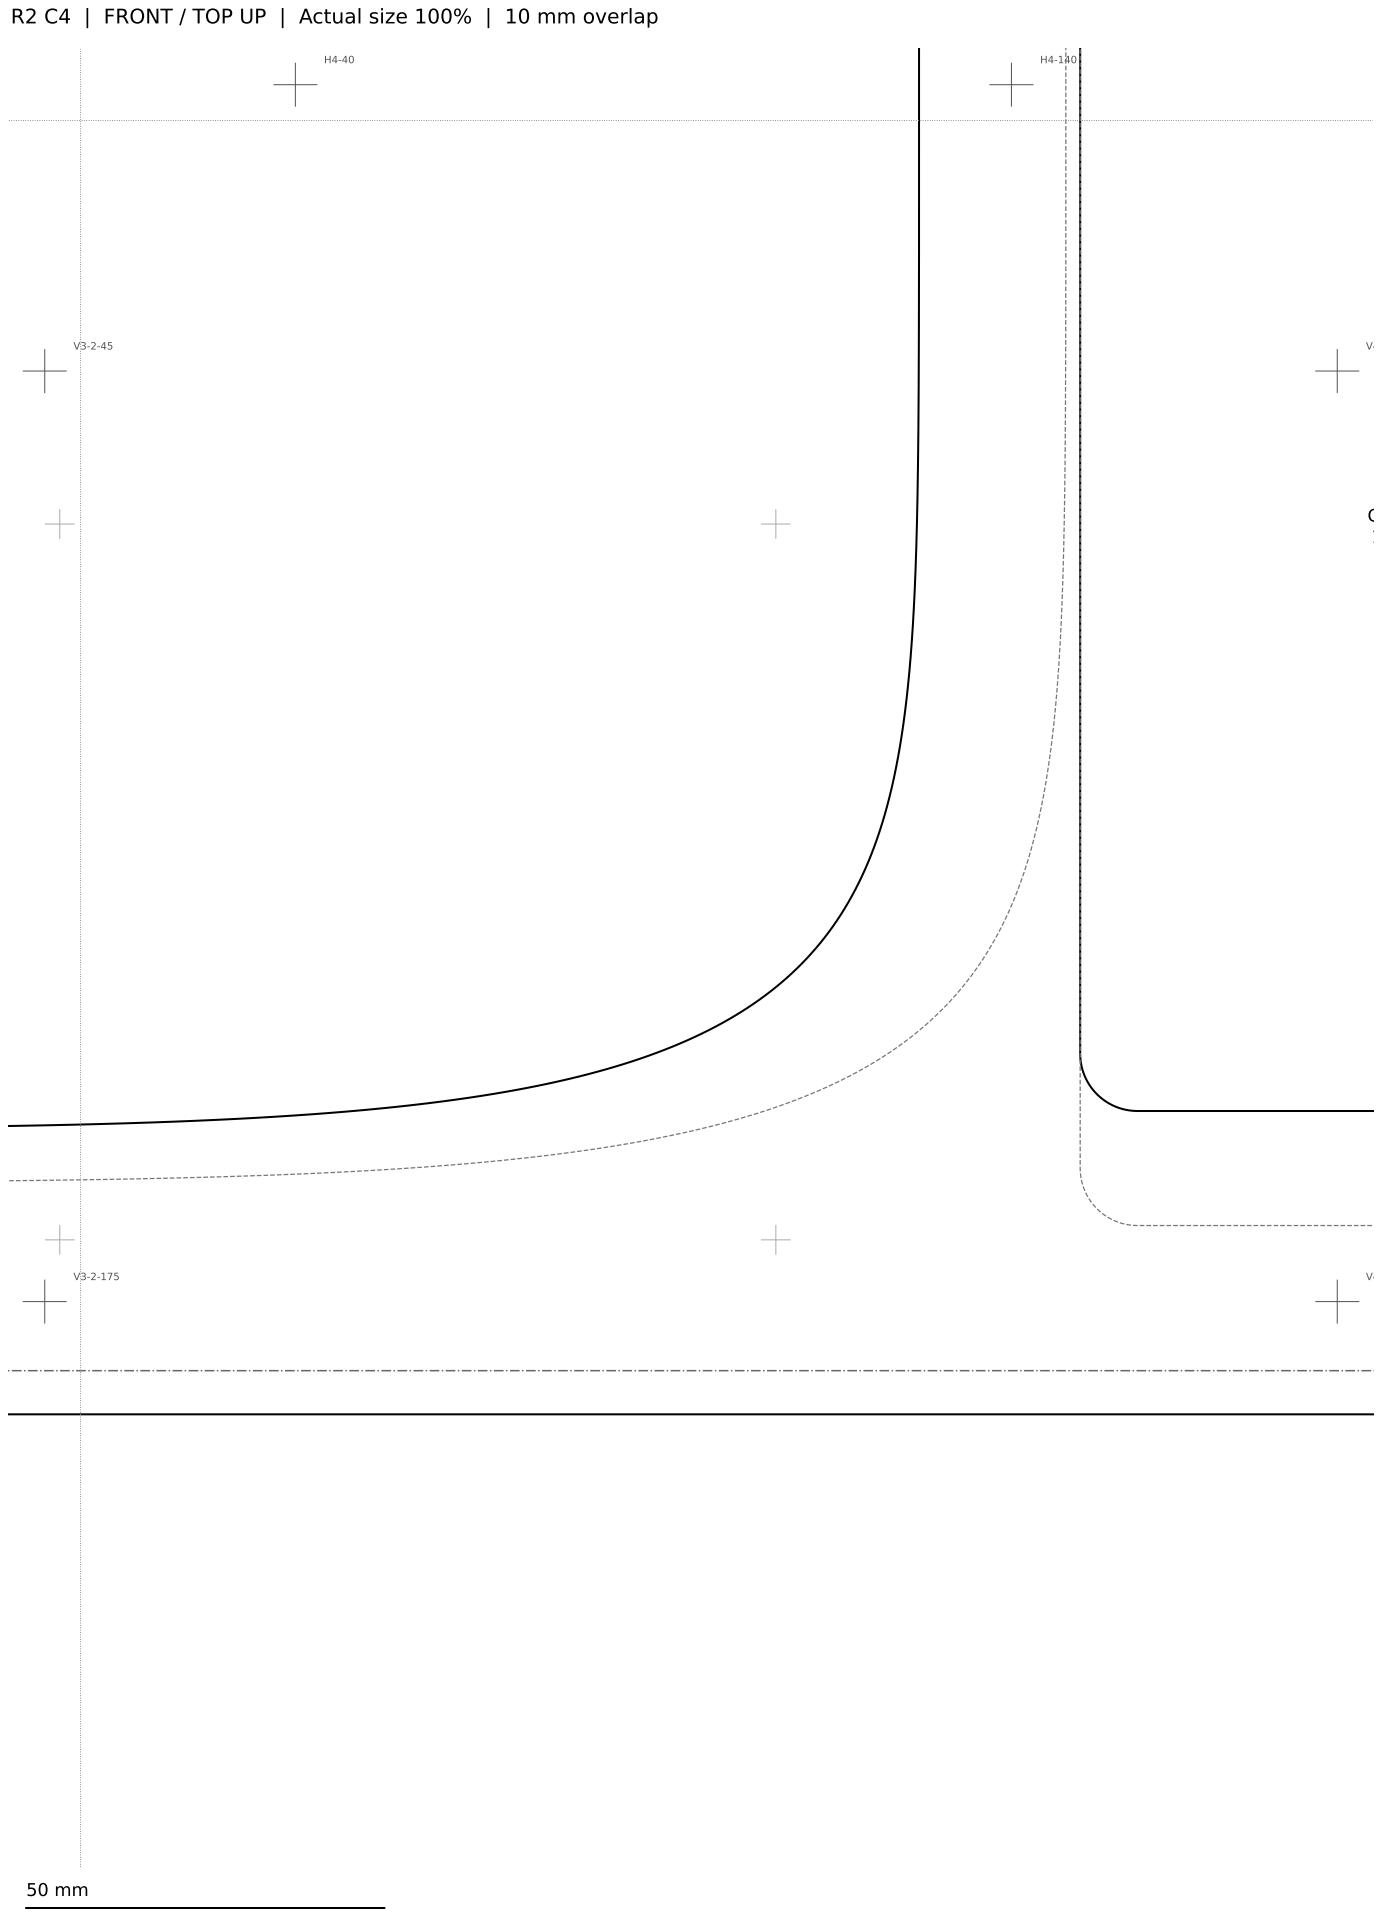
[picture p36: page 10]
GRILLE CUTOUT 100 × 160 mm R8 corners

R2 C4 | FRONT / TOP UP | Actual size 100% | 10 mm overlap

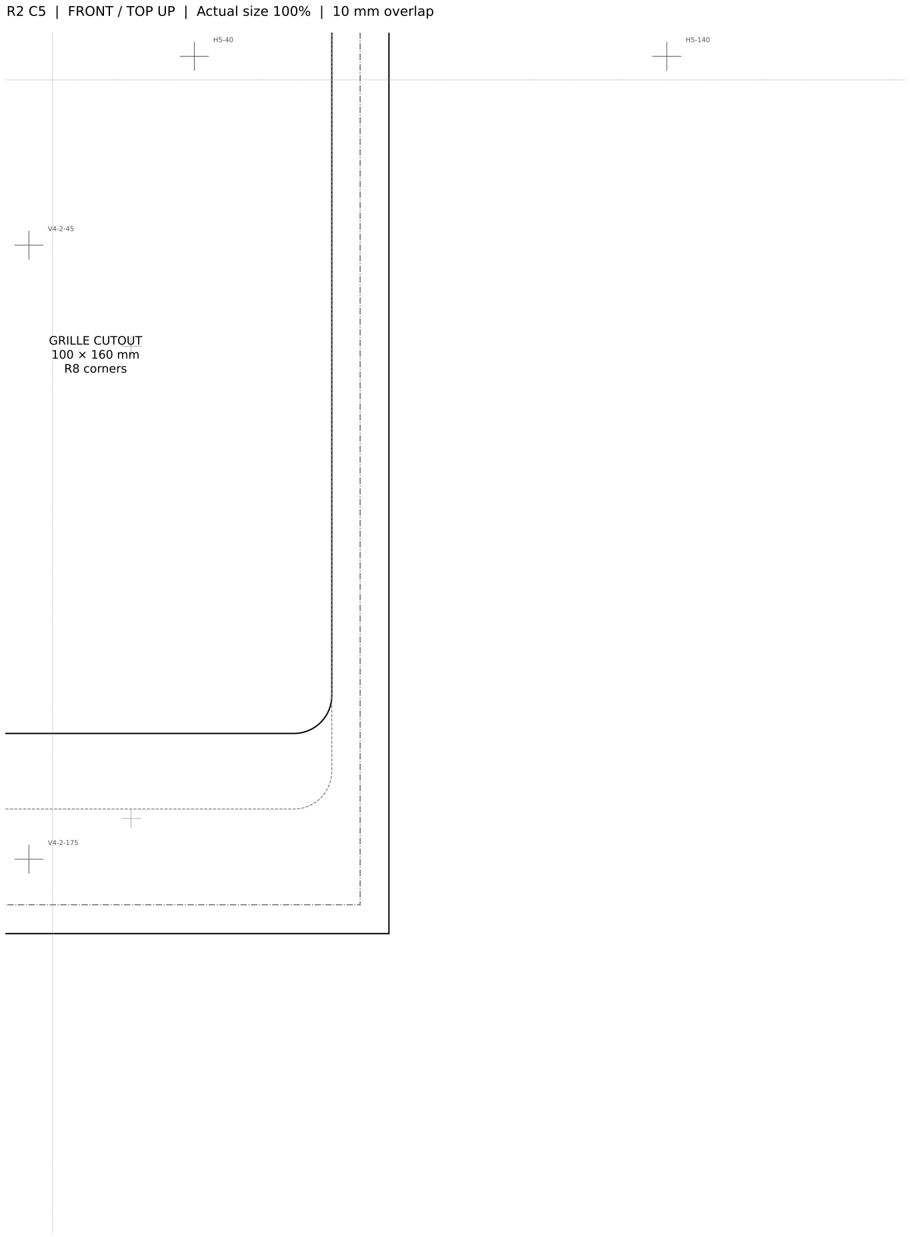
[picture p37: figure]
GRILLE CUTOUT 100 × 160 mm R8 corners

R2 C5 | FRONT / TOP UP | Actual size 100% | 10 mm overlap
