ThatOneGuyDavid/retro-tv-frame/design/bezel/requirements-step.txt

cadquery==2.8.0
numpy==2.5.4
trimesh==5.2.0
scipy==1.18.1
manifold3d==3.5.4
rtree==1.4.1
