ThatOneGuyDavid/retro-tv-frame/design/assembly/assembly-clearances.png

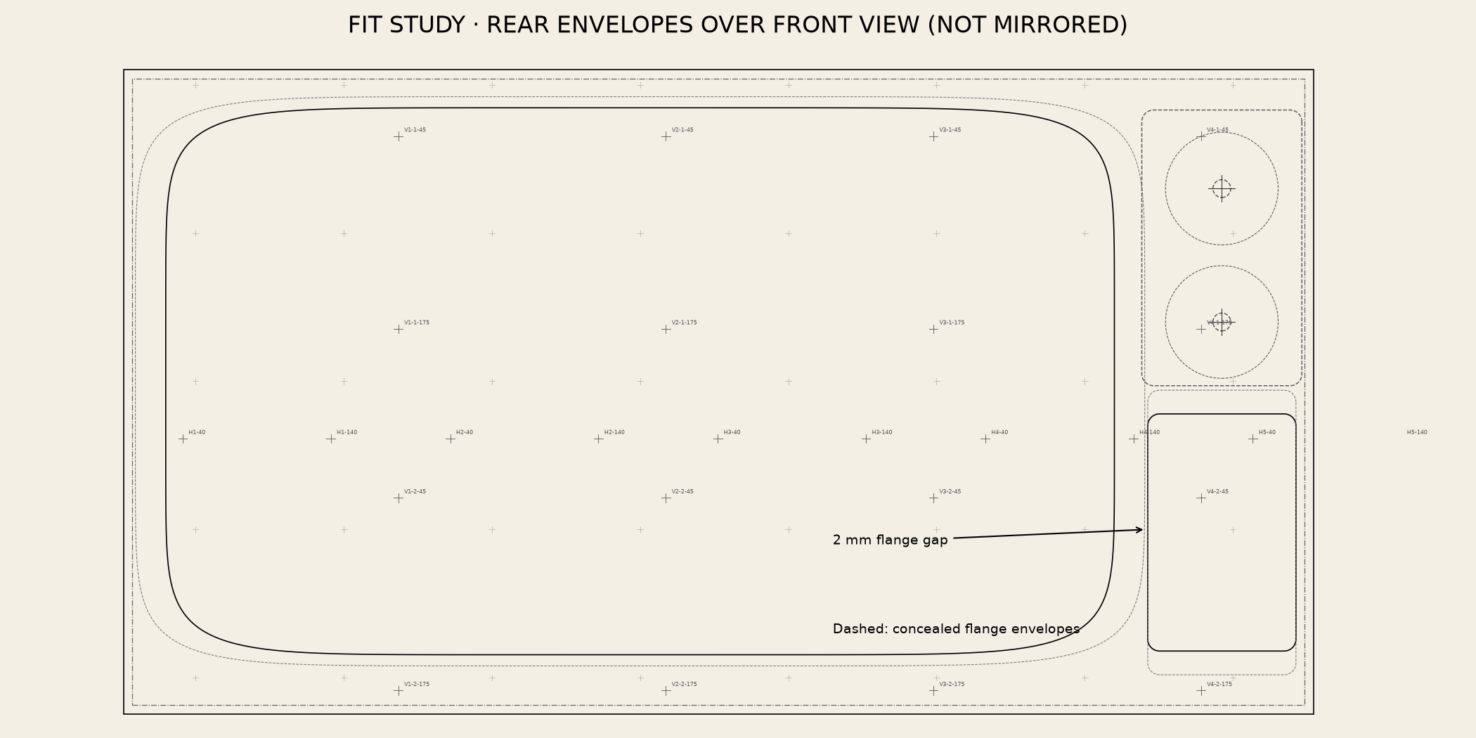
design/assembly/assembly-clearances.png
