ThatOneGuyDavid/retro-tv-frame/(commit log)

2026-11-09 Share retro TV frame design as a work in progress
    [alignment-fit-test.stl, bezel-assembled.stl, bezel-left.stl, bezel-right.stl, blank-hub.stl, brass-trim.stl, center-cap.stl, dial-plate.stl]
2026-11-09 Link the live assembly preview and serve static Pages files
2026-11-09 Give the bezel inner rim a flat printing land and verify brim generation
    [alignment-fit-test.stl, bezel-assembled.stl, bezel-left.stl, bezel-right.stl, display-fit-test.stl, joint-test-left.stl, joint-test-right.stl]
2026-11-10 Document bezel v8 as current and record successful test print
2026-11-12 Add editable STEP solids and CAD source for green bezel
    [bezel-assembled.step, bezel-left.step, bezel-right.step, joining-key.step]
